Photo-Finish/aviation-model/README.md

# aviation-model
A log of the aviation competition 2025-26. Non-CUADC.
