Photo-Finish/aviation-model/飞机元器件拆解/飞机元器件拆解/激光切割/主机翼/readme.md

下面是主机翼的BOM清单

//comment 2026/2/10 9:39 :等待之后过来检查一下是否齐全

//comment 2026/2/11 :检查完成

**#Part1:激光切割**

* 关于翼肋：

 		翼肋编号从1-10 (文件名： main\_wing\_第xx块翼肋 ) 每个**各打印两个**

* 关于小翼：

 		小翼(文件名：main\_wing\_平面版小翼\_可以是木板 )**打印两个**

* 第二横梁：

 		(文件名：main\_wing\_第二横梁 )**打印一个**

* 襟翼前龙骨挡板：

 		(文件名：襟翼前龙骨挡板 )**打印一个**

* 副翼前挡板：

 		(文件名：副翼前挡板) **打印两个**

**#Part2:3D打印**

* 关于副翼：

 		副翼正反(文件名分别为：副翼 、Mirror副翼 )**各打印一个**

* 关于襟翼：

 		襟翼正反(文件名分别为：襟翼 、Mirror襟翼 )**各打印一个**

**#Part3:其他材料**

* 碳纤维管 **半径**：4mm  长度： 570mm  购买两个
