Photo-Finish/aviation-model/飞机元器件拆解/飞机元器件拆解/激光切割/垂直尾翼/readme.md

下面是垂直尾翼的BOM清单

//comment 2026/2/11 10:39 ：等待检查

//comment 2026/2/11 10:45 :已经检查

**#Part1:激光切割**

* 关于翼肋：

 		翼肋编号从 一到二 (文件名： fin\_第xx翼肋\_高度为59 ) 每个**各打印一个**

* 方向舵前挡板：

 		(文件名：fin\_方向舵前挡板\_高度为59 )**打印一个**

* 卡扣：

 		(文件名：fin\_卡扣\_高度为59)一个零件由一个部分组成 **需要打印一次**

**#Part2:3D打印**

* 关于方向舵：

 		方向舵(文件名分别为：fin\_方向舵\_高度为59 )**打印一个**

**#Part3:其他材料**

* 碳纤维管 **半径**：0.25mm  长度： 85mm  购买一个
