Photo-Finish/aviation-model/飞机元器件拆解/飞机元器件拆解/激光切割/水平尾翼/readme.md

下面是水平尾翼的BOM清单

//comment 2026/2/11 10:20 ：等待检查

//comment 2026/2/11 10:25 :已经检查

**#Part1:激光切割**

* 关于翼肋：

 		翼肋编号从 一到六 (文件名： tail\_第xx块翼肋 ) 每个**各打印两个**

* 升降舵前挡板：

 		(文件名：襟翼前龙骨挡板 )**打印两个**

* 卡扣：

&nbsp;		(文件名：tail\_卡扣)一个零件由独立的两部分组成 **需要打印两次**

**#Part2:3D打印**

* 关于升降舵：

 		升降舵正反(文件名分别为：升降舵 、Mirror升降舵 )**各打印一个**

**#Part3:其他材料**

* 碳纤维管 **半径**：2mm  长度： 350mm  购买两个
