Photo-Finish/aviation-model/飞机元器件拆解/飞机元器件拆解/readme.md

注：所有零件分成3D打印与激光切割

对于激光切割，在无特殊说明的情况下默认采用2mm厚度的轻木

同时，对于飞机每个部分 (主机翼、水平尾翼、垂直尾翼、机身)

在对于的激光切割文件夹下的对应子文件夹内有BOM表，可以查阅

3D打印默认导出为.stp/.step文件

激光切割默认导出为.dxf 图(同时记得删去非切割面)
