Photo-Finish/aviation-model/航模设计Vcs_4.0/航模设计Vcs_4.0/versions.md

###### UCAS航模三段机翼设计-yali组

**Vcs:4.0**

* **大改垂直尾翼，同时调整主机翼的安装**
* 
**Vcs:3.0**

更新公告：

* ( 气动工程师 ): 新建联合主机翼文件，参考载荷工程师的机身尺寸，制作了完整的主机翼模型
* ( 气动工程师 ): 增加水平尾翼与垂直尾翼与机身的连接件，通过榫卯结构加固了部分连接部分

**Vcs:2.0**

更新公告:

* ( 气动工程师 ): 优化了碳纤维棒穿孔的直径，通常比预设的半径大了0.1-0.2mm左右，优化了安装体验
