Photo-Finish/aviation-model/Cessna 208 Caravan.webp

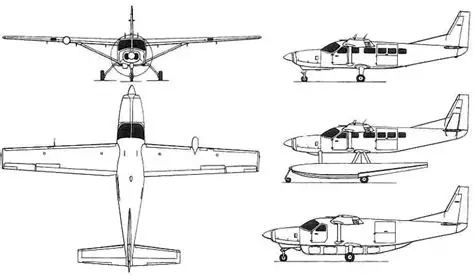
Cessna 208 Caravan.webp
