Photo-Finish/aviation-model/Fuselage/Fuck Everything ~/de Havilland DHC-2 Beaver.jpg

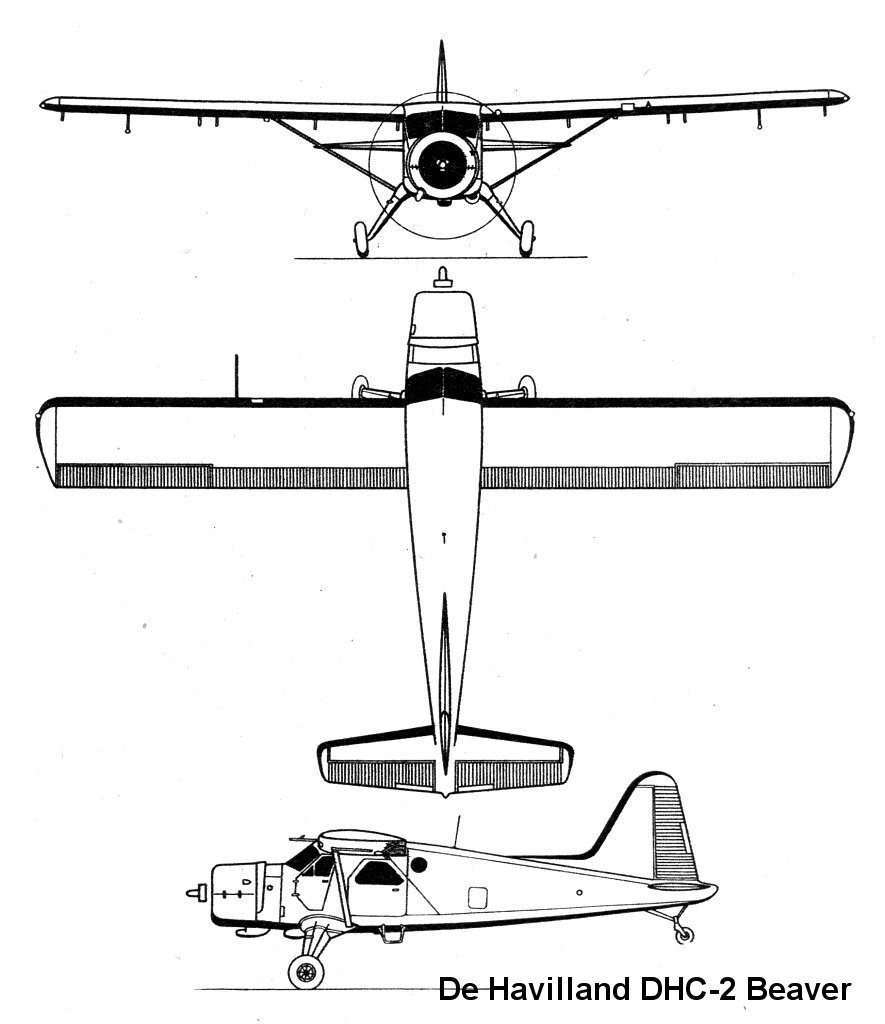
Fuselage/Fuck Everything ~/de Havilland DHC-2 Beaver.jpg
