Photo-Finish/aviation-model/航模 次终稿/modifier.jpg

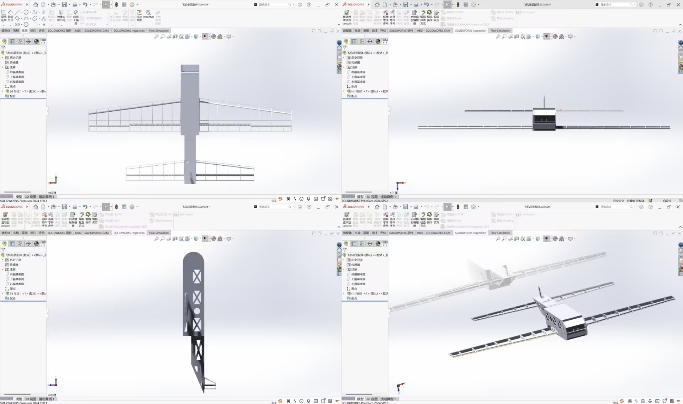
航模 次终稿/modifier.jpg
