Photo-Finish/aviation-model/航模 次终稿/λ的约束作图结果 (1).png

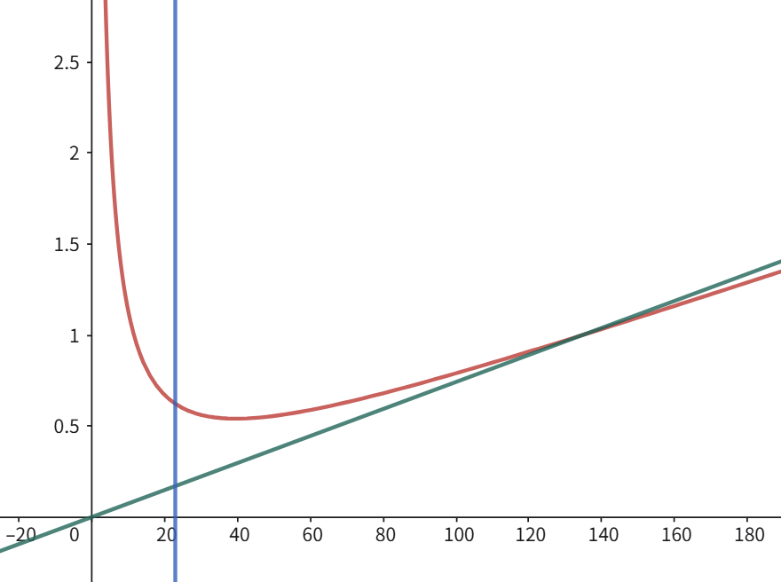
航模 次终稿/λ的约束作图结果 (1).png
