Photo-Finish/aviation-model/飞机元器件拆解/飞机元器件拆解/激光切割/主机翼/main_wing_第二块翼肋.DXF

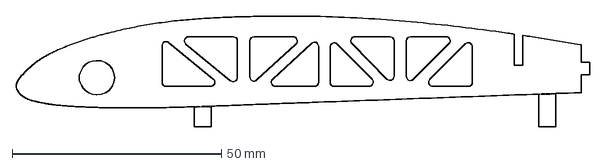
[picture p20: CAD file, 2026-07-26]
飞机元器件拆解/飞机元器件拆解/激光切割/主机翼/main_wing_第二块翼肋.DXF
136.9 x 26.5 mm
