Photo-Finish/aviation-model/飞机元器件拆解/飞机元器件拆解/激光切割/主机翼/main_wing_平面版小翼_可以是木板.DXF

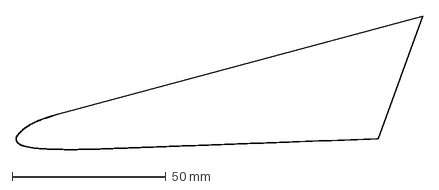
[picture p21: CAD file, 2026-07-26]
飞机元器件拆解/飞机元器件拆解/激光切割/主机翼/main_wing_平面版小翼_可以是木板.DXF
132.2 x 43.3 mm
