Photo-Finish/aviation-model/航模设计Vcs_4.0/航模设计Vcs_4.0/主机翼/main_wing_第八块翼肋.SLDPRT

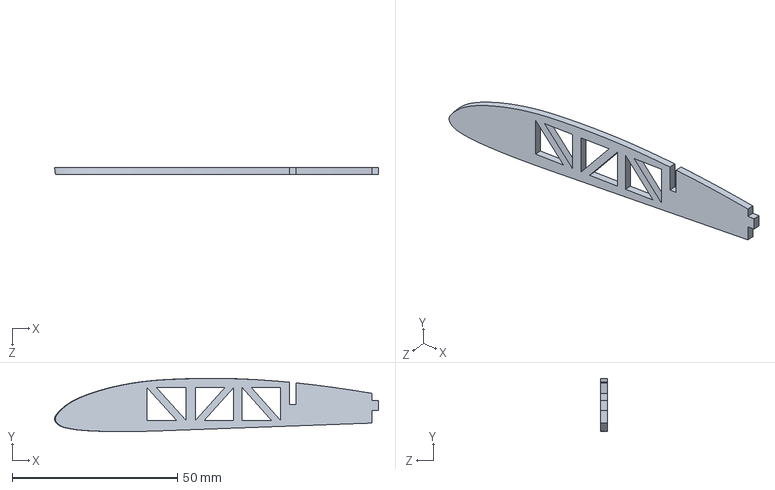
[picture p22: CAD file, 2026-07-26]
航模设计Vcs_4.0/航模设计Vcs_4.0/主机翼/main_wing_第八块翼肋.SLDPRT
98.1 x 16.1 x 2.00 mm
