Photo-Finish/aviation-model/飞机元器件拆解/飞机元器件拆解/激光切割/主机翼/main_wing_第一块翼肋.DXF

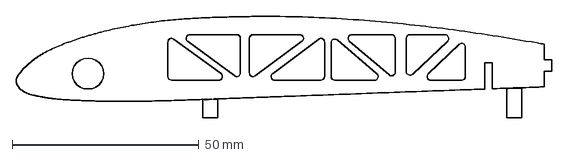
[picture p23: CAD file, 2026-07-26]
飞机元器件拆解/飞机元器件拆解/激光切割/主机翼/main_wing_第一块翼肋.DXF
143.3 x 27.1 mm
