Photo-Finish/aviation-model/飞机元器件拆解/飞机元器件拆解/激光切割/主机翼/main_wing_第三块翼肋.DXF

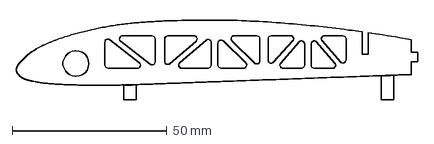
[picture p24: CAD file, 2026-07-26]
飞机元器件拆解/飞机元器件拆解/激光切割/主机翼/main_wing_第三块翼肋.DXF
129.8 x 25.9 mm
