Photo-Finish/aviation-model/航模设计Vcs_4.0/航模设计Vcs_4.0/主机翼/main_wing_第三块翼肋.SLDPRT

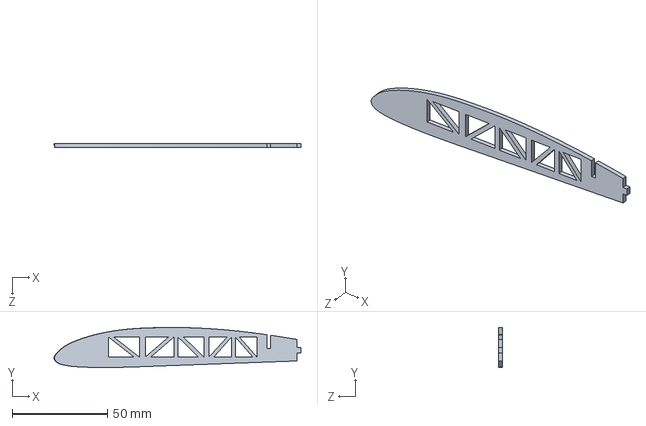
[picture p25: CAD file, 2026-07-26]
航模设计Vcs_4.0/航模设计Vcs_4.0/主机翼/main_wing_第三块翼肋.SLDPRT
129.8 x 21.1 x 2.00 mm
