Photo-Finish/aviation-model/飞机元器件拆解/飞机元器件拆解/激光切割/主机翼/main_wing_第六块翼肋.DXF

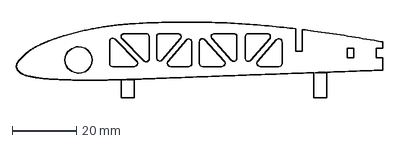
[picture p26: CAD file, 2026-07-26]
飞机元器件拆解/飞机元器件拆解/激光切割/主机翼/main_wing_第六块翼肋.DXF
113.6 x 23.5 mm
