Photo-Finish/aviation-model/航模设计Vcs_4.0/航模设计Vcs_4.0/主机翼/A_main_主机翼装配.SLDASM

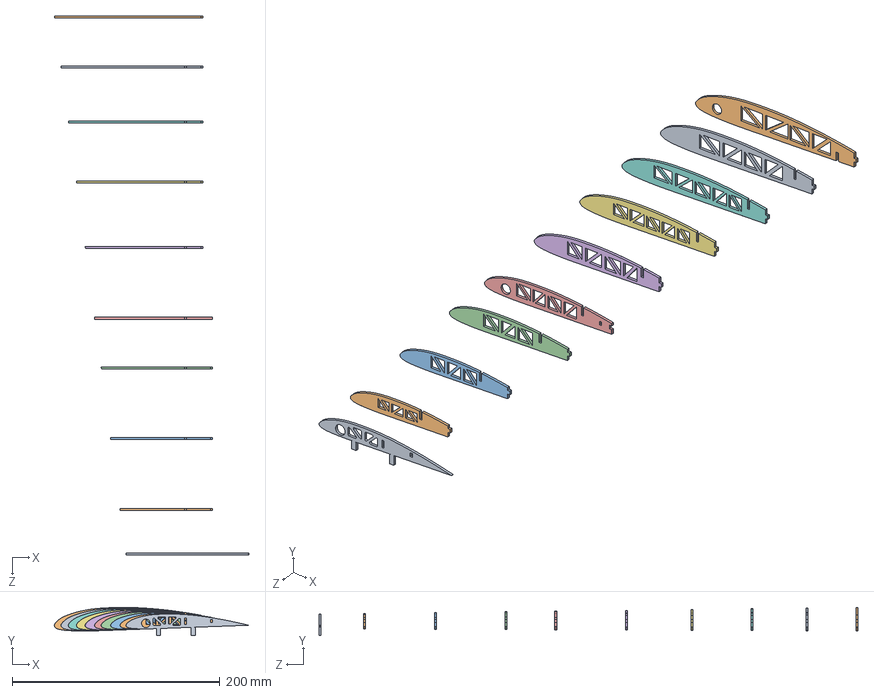
[picture p27: CAD file, 2026-07-26]
航模设计Vcs_4.0/航模设计Vcs_4.0/主机翼/A_main_主机翼装配.SLDASM
187.3 x 27.1 x 519.0 mm
main_wing_第一块翼肋
main_wing_第二块翼肋
main_wing_第三块翼肋
main_wing_第四块翼肋
main_wing_第五块翼肋
main_wing_第六块翼肋
main_wing_第七块翼肋
main_wing_第八块翼肋
main_wing_第九块翼肋
main_wing_第十块翼肋
