Photo-Finish/aviation-model/飞机元器件拆解/飞机元器件拆解/激光切割/主机翼/main_wing_第七块翼肋.DXF

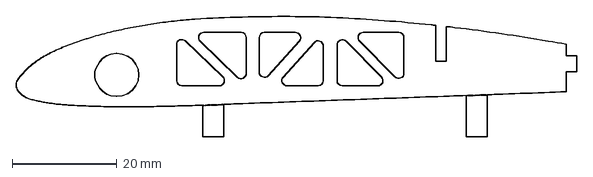
[picture p28: CAD file, 2026-07-26]
飞机元器件拆解/飞机元器件拆解/激光切割/主机翼/main_wing_第七块翼肋.DXF
107.2 x 23.0 mm
