Photo-Finish/aviation-model/航模设计Vcs_4.0/航模设计Vcs_4.0/主机翼/main_wing_第六块翼肋.SLDPRT

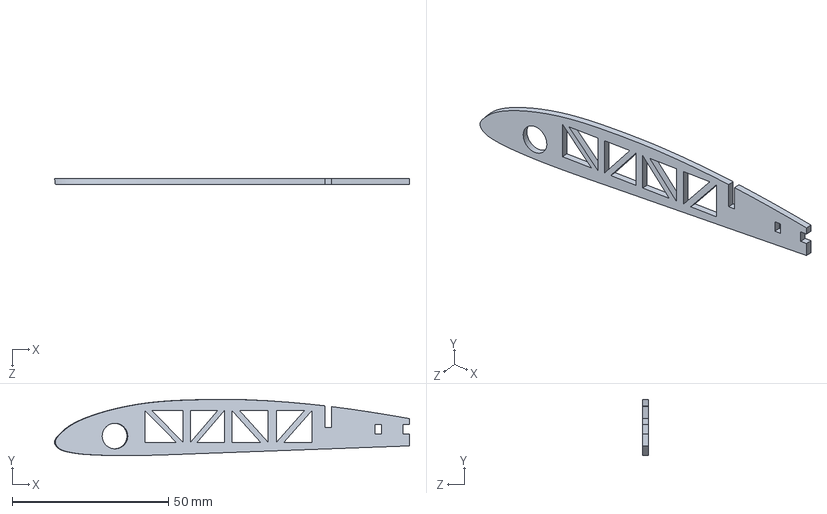
[picture p29: CAD file, 2026-07-26]
航模设计Vcs_4.0/航模设计Vcs_4.0/主机翼/main_wing_第六块翼肋.SLDPRT
113.6 x 18.0 x 2.00 mm
