Photo-Finish/aviation-model/航模设计Vcs_4.0/航模设计Vcs_4.0/主机翼/main_wing_第二横梁.SLDPRT

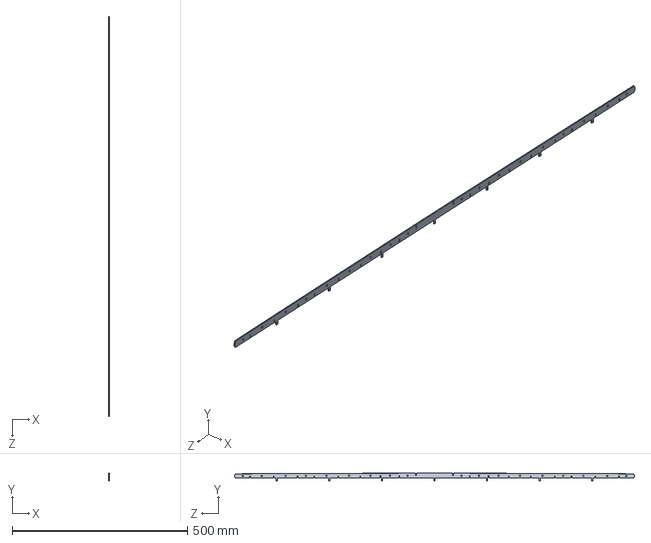
[picture p31: CAD file, 2026-07-26]
航模设计Vcs_4.0/航模设计Vcs_4.0/主机翼/main_wing_第二横梁.SLDPRT
2.00 x 22.3 x 1142.0 mm
