Photo-Finish/aviation-model/航模设计Vcs_4.0/航模设计Vcs_4.0/主机翼/main_wing_第九块翼肋.SLDPRT

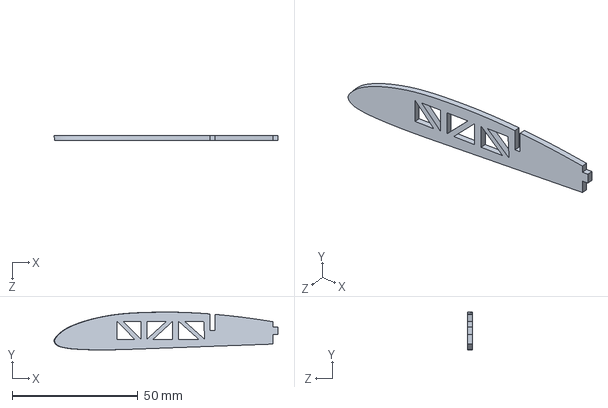
[picture p33: CAD file, 2026-07-26]
航模设计Vcs_4.0/航模设计Vcs_4.0/主机翼/main_wing_第九块翼肋.SLDPRT
89.0 x 15.0 x 2.00 mm
