Photo-Finish/aviation-model/航模设计Vcs_4.0/航模设计Vcs_4.0/主机翼/main_wing_第一横梁.SLDPRT

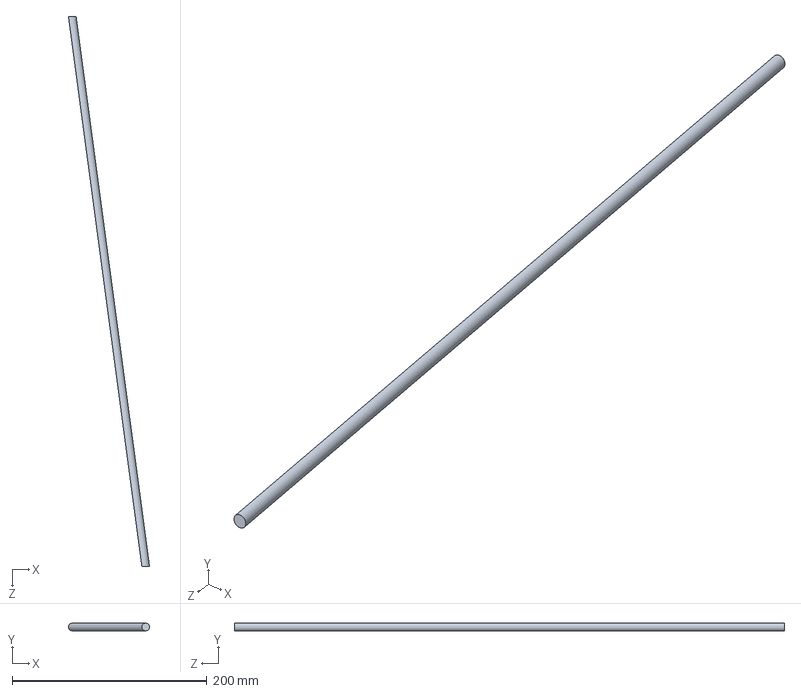
[picture p36: CAD file, 2026-07-26]
航模设计Vcs_4.0/航模设计Vcs_4.0/主机翼/main_wing_第一横梁.SLDPRT
83.4 x 7.96 x 565.0 mm
