Photo-Finish/aviation-model/航模设计Vcs_4.0/航模设计Vcs_4.0/主机翼/main_wing_第二块翼肋.SLDPRT

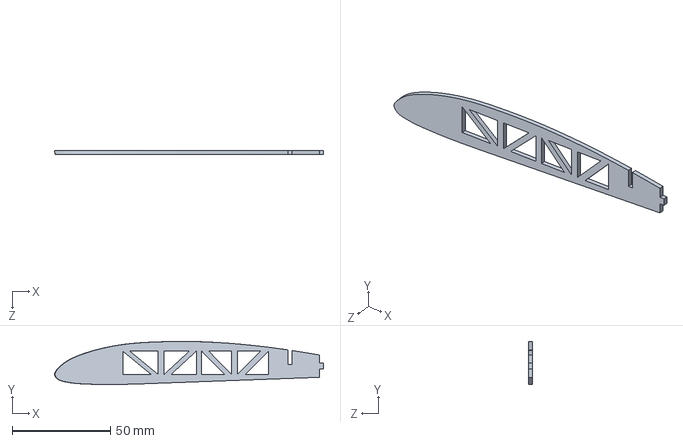
[picture p38: CAD file, 2026-07-26]
航模设计Vcs_4.0/航模设计Vcs_4.0/主机翼/main_wing_第二块翼肋.SLDPRT
136.9 x 21.9 x 2.00 mm
