Photo-Finish/aviation-model/航模设计Vcs_4.0/航模设计Vcs_4.0/主机翼/main_wing_曲面版小翼_3D打印件.SLDPRT

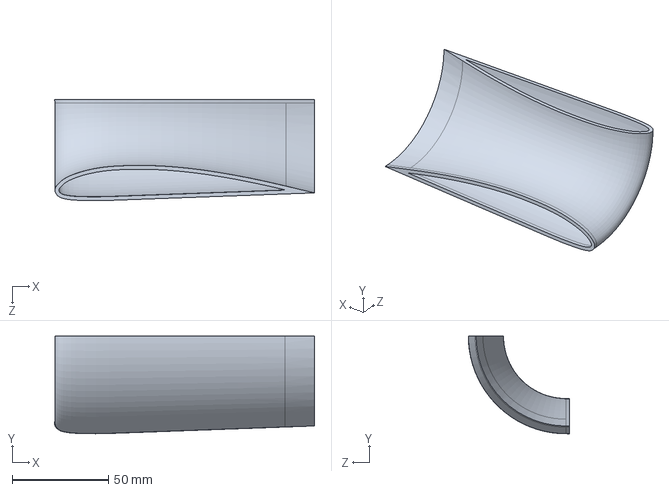
[picture p40: CAD file, 2026-07-26]
航模设计Vcs_4.0/航模设计Vcs_4.0/主机翼/main_wing_曲面版小翼_3D打印件.SLDPRT
135.1 x 50.7 x 52.7 mm
