Photo-Finish/aviation-model/航模设计Vcs_4.0/航模设计Vcs_4.0/主机翼/main_wing_第十块翼肋.SLDPRT

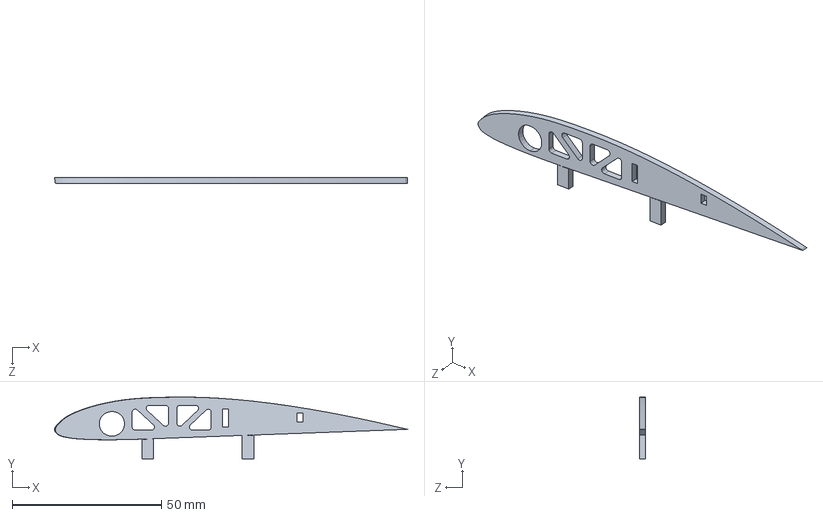
[picture p41: CAD file, 2026-07-26]
航模设计Vcs_4.0/航模设计Vcs_4.0/主机翼/main_wing_第十块翼肋.SLDPRT
118.3 x 20.8 x 2.00 mm
