Photo-Finish/aviation-model/航模设计Vcs_4.0/航模设计Vcs_4.0/主机翼/main_wing_第一块翼肋.SLDPRT

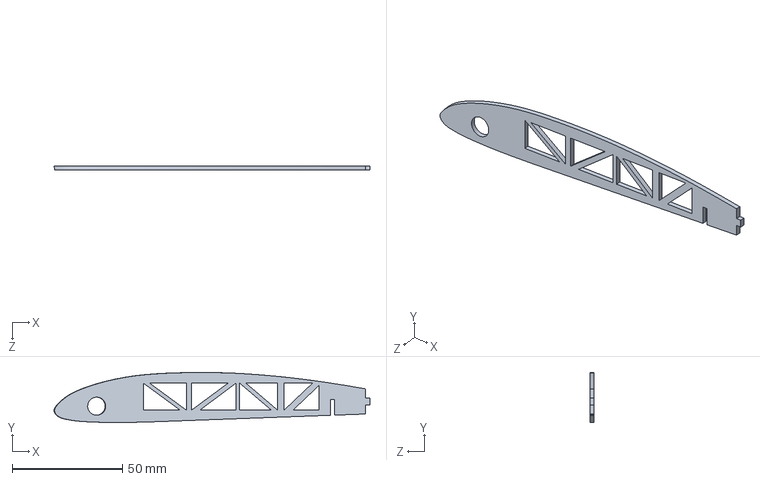
[picture p42: CAD file, 2026-07-26]
航模设计Vcs_4.0/航模设计Vcs_4.0/主机翼/main_wing_第一块翼肋.SLDPRT
143.3 x 22.7 x 2.00 mm
