Photo-Finish/aviation-model/航模设计Vcs_4.0/航模设计Vcs_4.0/主机翼/main_wing_第七块翼肋.SLDPRT

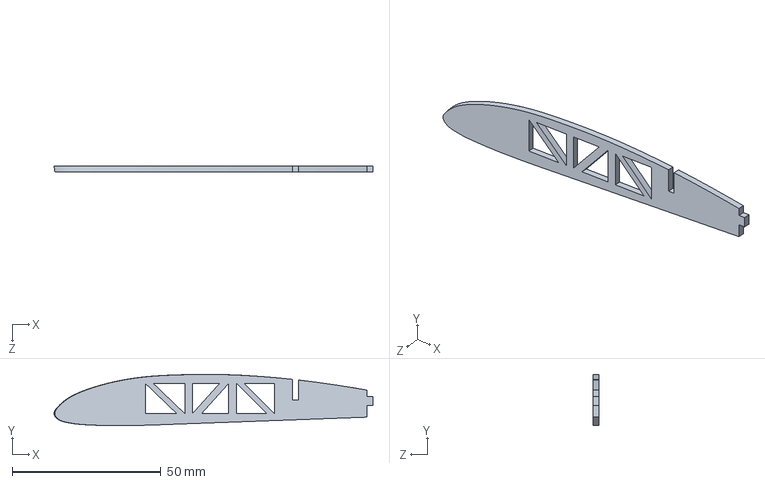
[picture p44: CAD file, 2026-07-26]
航模设计Vcs_4.0/航模设计Vcs_4.0/主机翼/main_wing_第七块翼肋.SLDPRT
107.2 x 17.3 x 2.00 mm
