Photo-Finish/aviation-model/航模设计Vcs_4.0/航模设计Vcs_4.0/主机翼/main_wing_引导塑料薄膜附着.SLDPRT

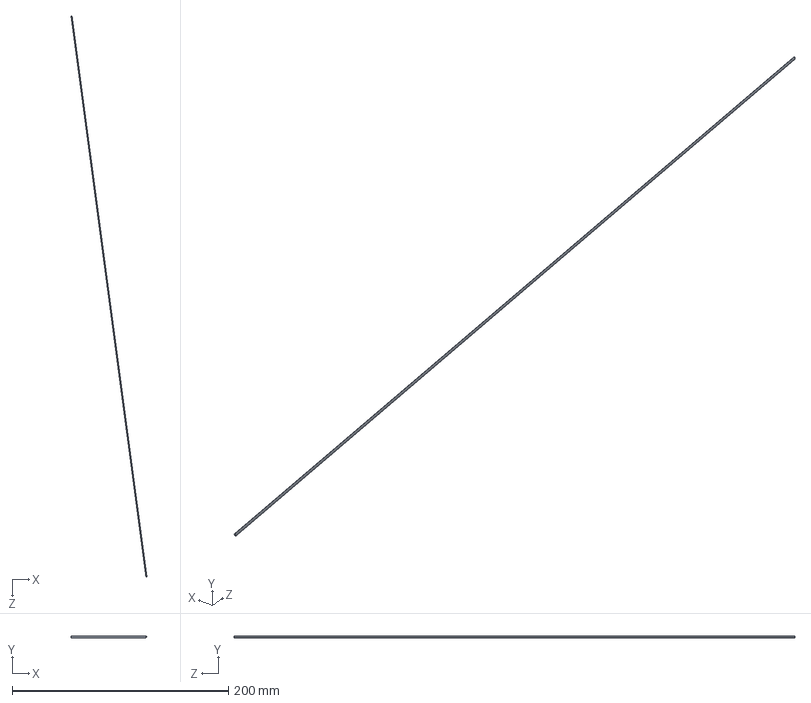
[picture p45: CAD file, 2026-07-26]
航模设计Vcs_4.0/航模设计Vcs_4.0/主机翼/main_wing_引导塑料薄膜附着.SLDPRT
70.3 x 1.68 x 519.0 mm
