Photo-Finish/aviation-model/航模设计Vcs_4.0/航模设计Vcs_4.0/主机翼/main_wing_平面版小翼_可以是木板.SLDPRT

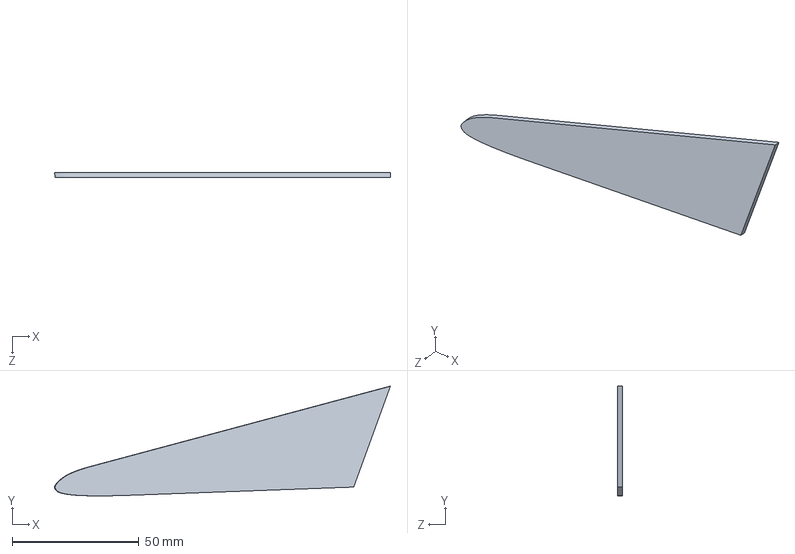
[picture p46: CAD file, 2026-07-26]
航模设计Vcs_4.0/航模设计Vcs_4.0/主机翼/main_wing_平面版小翼_可以是木板.SLDPRT
132.5 x 43.4 x 2.00 mm
