Photo-Finish/aviation-model/航模设计Vcs_4.0/航模设计Vcs_4.0/主机翼/main_wing_第四块翼肋.SLDPRT

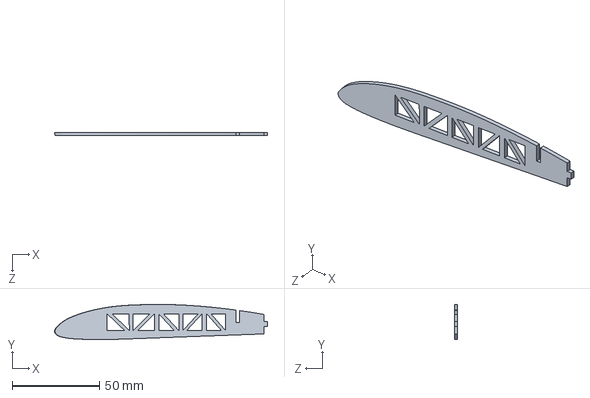
[picture p47: CAD file, 2026-07-26]
航模设计Vcs_4.0/航模设计Vcs_4.0/主机翼/main_wing_第四块翼肋.SLDPRT
122.1 x 20.2 x 2.00 mm
