Photo-Finish/aviation-model/_temp/tail side original.SLDPRT

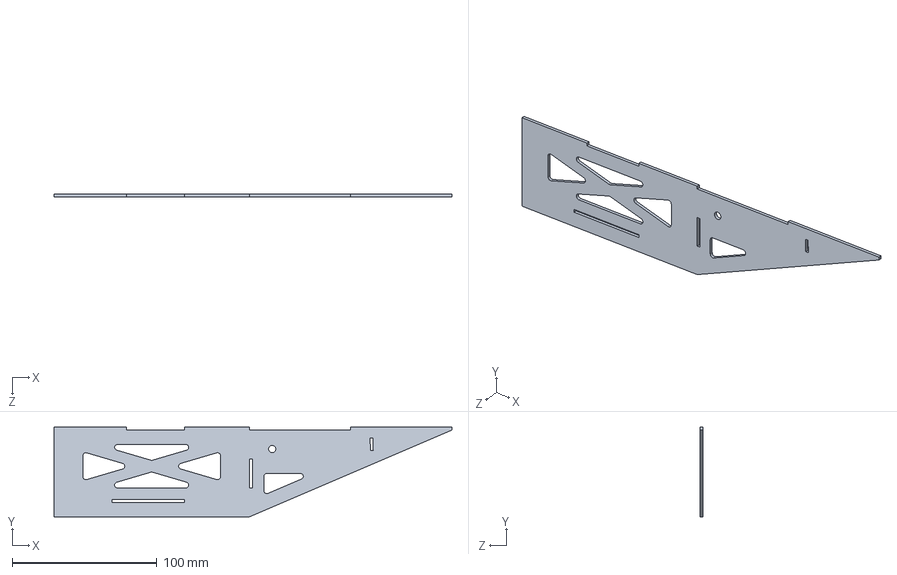
[picture p48: CAD file, 2026-07-26]
_temp/tail side original.SLDPRT
275.0 x 62.0 x 2.00 mm
