Photo-Finish/aviation-model/Apr. mod/windshear.SLDPRT

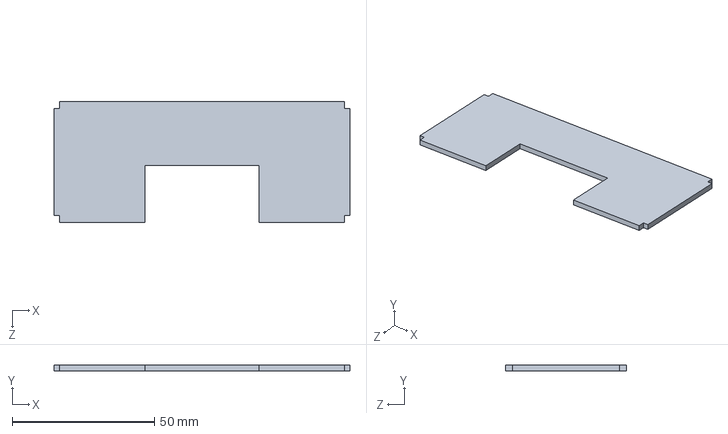
[picture p49: CAD file, 2026-07-26]
Apr. mod/windshear.SLDPRT
104.0 x 2.00 x 42.5 mm
