Photo-Finish/aviation-model/Fuselage/Fuck Everything Again ~/机头半圆形挡板.SLDPRT

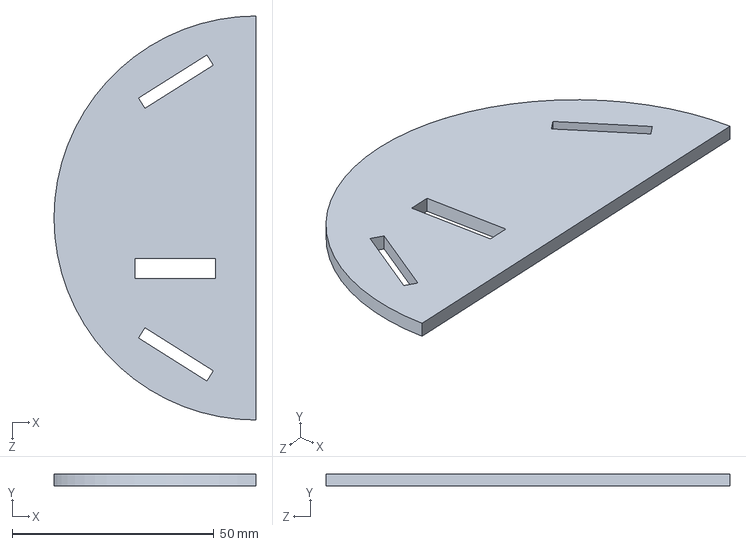
[picture p50: CAD file, 2026-07-26]
Fuselage/Fuck Everything Again ~/机头半圆形挡板.SLDPRT
50.0 x 3.00 x 100.0 mm
