Photo-Finish/aviation-model/Fuselage/tail floor.SLDPRT

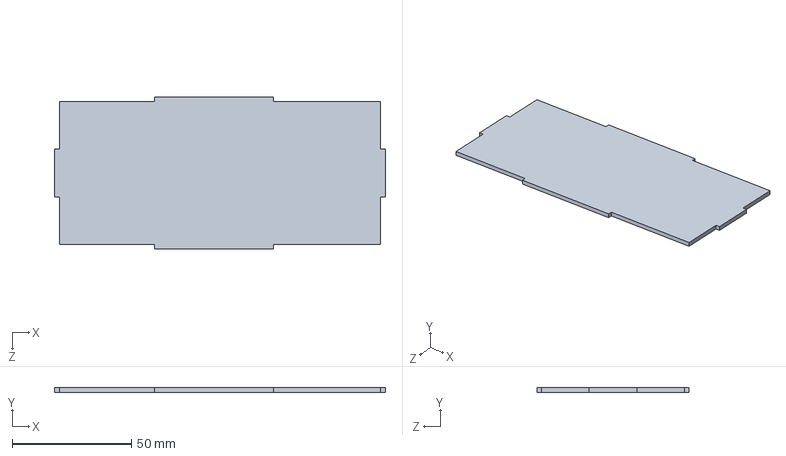
[picture p51: CAD file, 2026-07-26]
Fuselage/tail floor.SLDPRT
139.0 x 2.00 x 64.0 mm
