Photo-Finish/aviation-model/主机翼/主机翼/第二横梁.SLDPRT

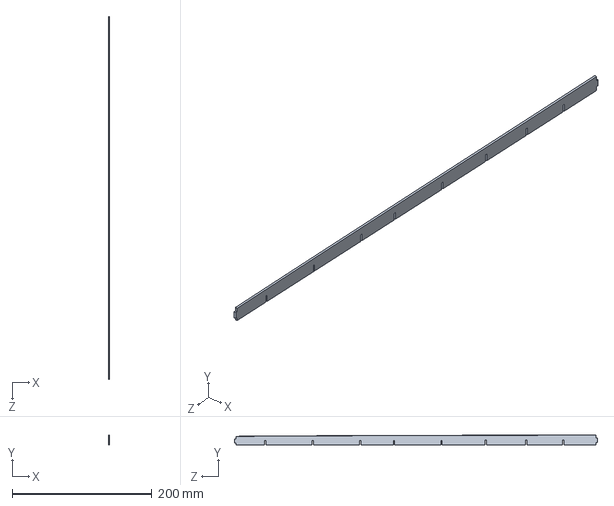
[picture p52: CAD file, 2026-07-26]
主机翼/主机翼/第二横梁.SLDPRT
2.00 x 14.6 x 519.0 mm
