Photo-Finish/aviation-model/垂直尾翼/垂直尾翼/塑料薄膜附着处.SLDPRT

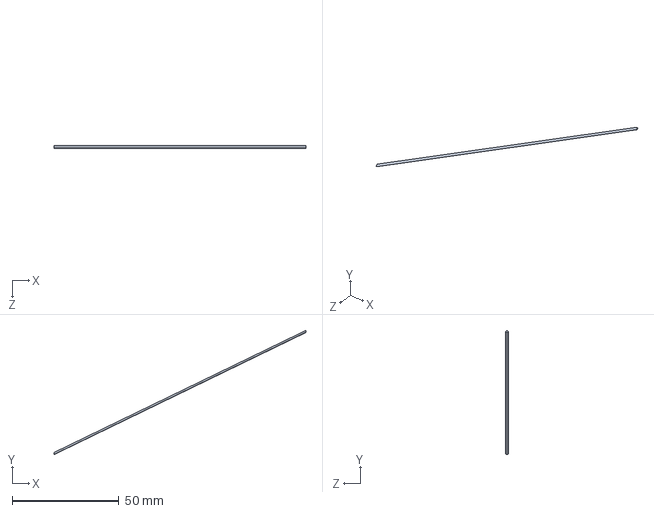
[picture p53: CAD file, 2026-07-26]
垂直尾翼/垂直尾翼/塑料薄膜附着处.SLDPRT
118.0 x 58.2 x 1.37 mm
