Photo-Finish/aviation-model/改个锤子！八十！/wheel struct F.STEP

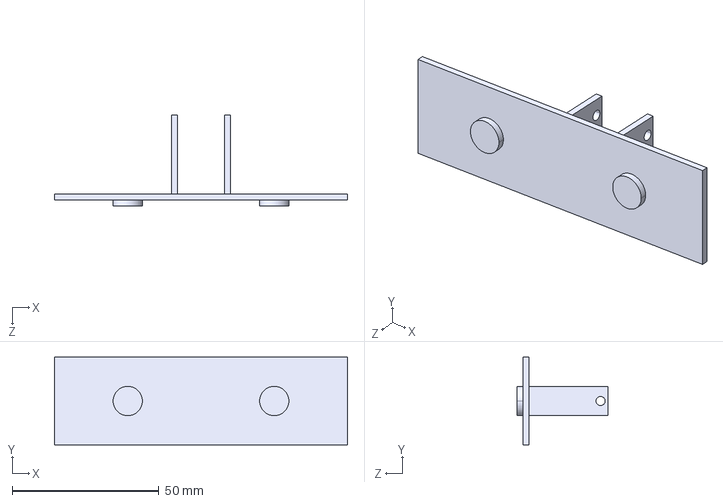
[picture p54: CAD file, 2026-07-26]
改个锤子！八十！/wheel struct F.STEP
100.0 x 30.0 x 31.0 mm
