Photo-Finish/aviation-model/水平尾翼/水平尾翼/升降舵前挡板.SLDPRT

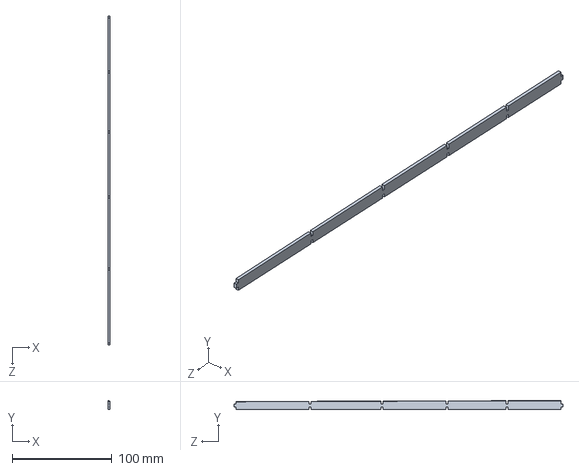
[picture p55: CAD file, 2026-07-26]
水平尾翼/水平尾翼/升降舵前挡板.SLDPRT
2.00 x 8.78 x 329.0 mm
