Photo-Finish/aviation-model/航模设计Vcs_4.0/航模设计Vcs_4.0/主机翼第二横梁固定件_总.SLDPRT

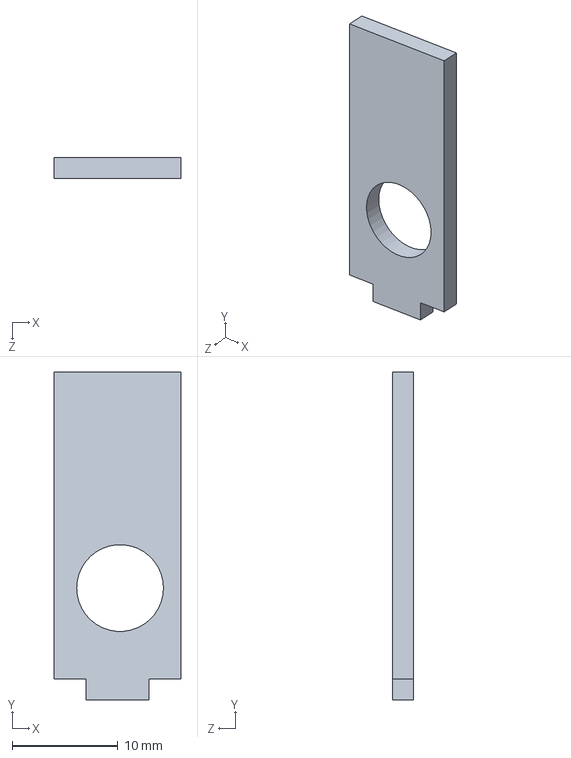
[picture p56: CAD file, 2026-07-26]
航模设计Vcs_4.0/航模设计Vcs_4.0/主机翼第二横梁固定件_总.SLDPRT
12.0 x 31.0 x 2.00 mm
