Photo-Finish/aviation-model/跑CFD的水平尾翼(只有一半).SLDPRT

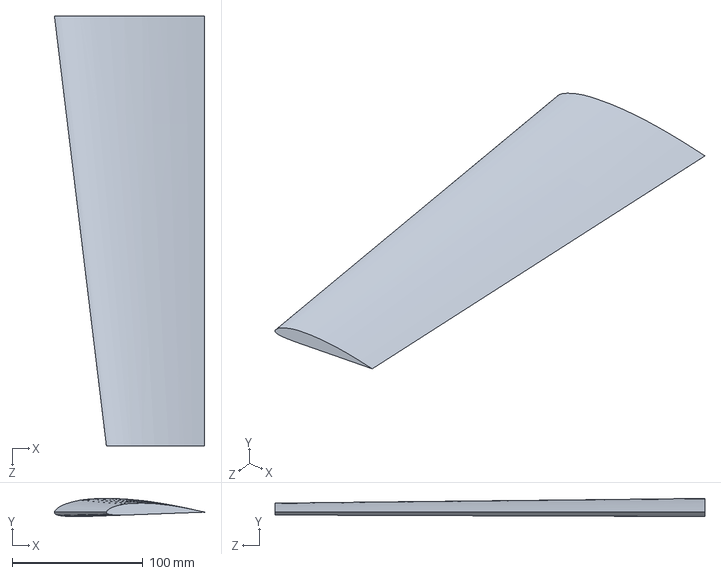
[picture p57: CAD file, 2026-07-26]
跑CFD的水平尾翼(只有一半).SLDPRT
114.9 x 13.9 x 329.0 mm
