Photo-Finish/aviation-model/飞机元器件拆解/飞机元器件拆解/3D打印/Mirror升降舵.STEP

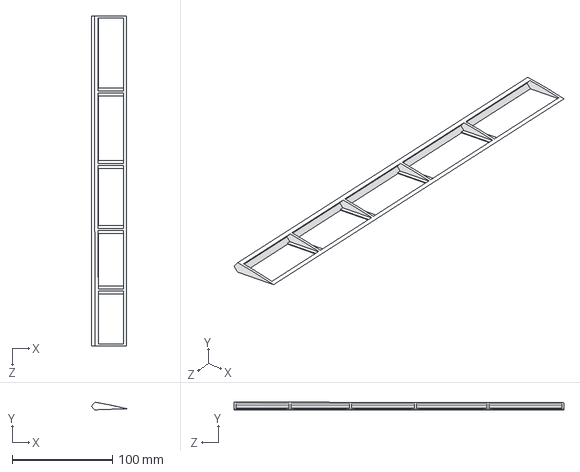
[picture p58: CAD file, 2026-07-26]
飞机元器件拆解/飞机元器件拆解/3D打印/Mirror升降舵.STEP
35.0 x 7.72 x 329.0 mm
