Photo-Finish/aviation-model/飞机元器件拆解/飞机元器件拆解/激光切割/垂直尾翼/fin_方向舵前挡板_高度为59.DXF

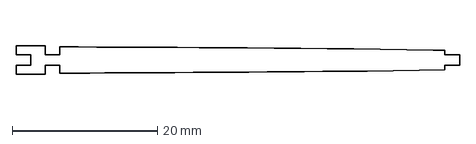
[picture p59: CAD file, 2026-07-26]
飞机元器件拆解/飞机元器件拆解/激光切割/垂直尾翼/fin_方向舵前挡板_高度为59.DXF
61.0 x 3.87 mm
