Photo-Finish/aviation-model/飞机元器件拆解/飞机元器件拆解/激光切割/水平尾翼/tail_第六块翼肋.DXF

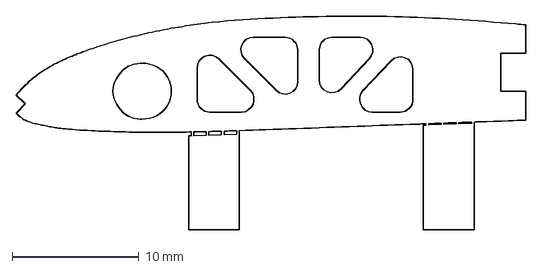
[picture p60: CAD file, 2026-07-26]
飞机元器件拆解/飞机元器件拆解/激光切割/水平尾翼/tail_第六块翼肋.DXF
40.3 x 16.9 mm
