Photo-Finish/aviation-model/Apr. mod/engine mount, floor.SLDPRT

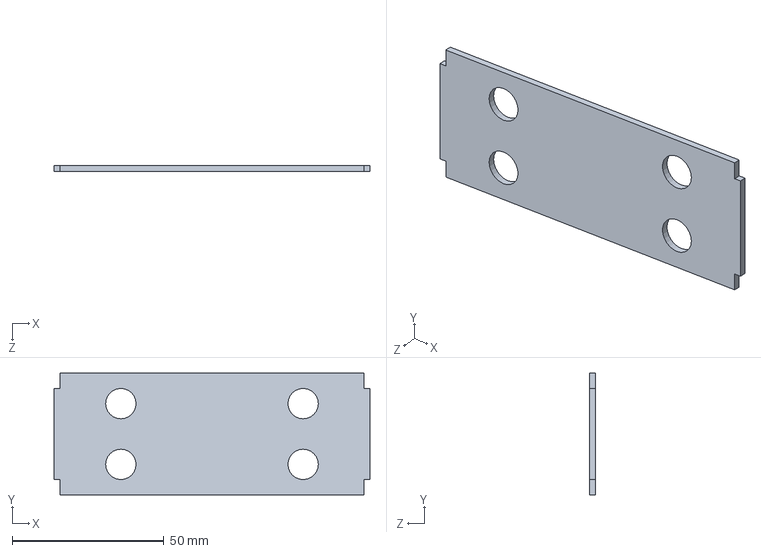
[picture p61: CAD file, 2026-07-26]
Apr. mod/engine mount, floor.SLDPRT
104.0 x 40.0 x 2.00 mm
