Photo-Finish/aviation-model/Fuselage/Fuck Everything Again ~/机头上下斜挡板.SLDPRT

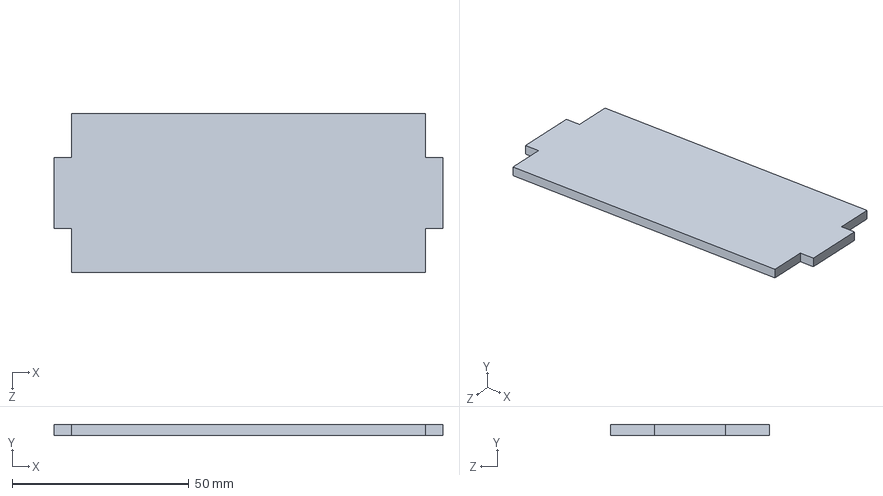
[picture p62: CAD file, 2026-07-26]
Fuselage/Fuck Everything Again ~/机头上下斜挡板.SLDPRT
110.0 x 3.00 x 45.0 mm
