Photo-Finish/aviation-model/Fuselage/Fuck Everything ~/Fuselage.stp

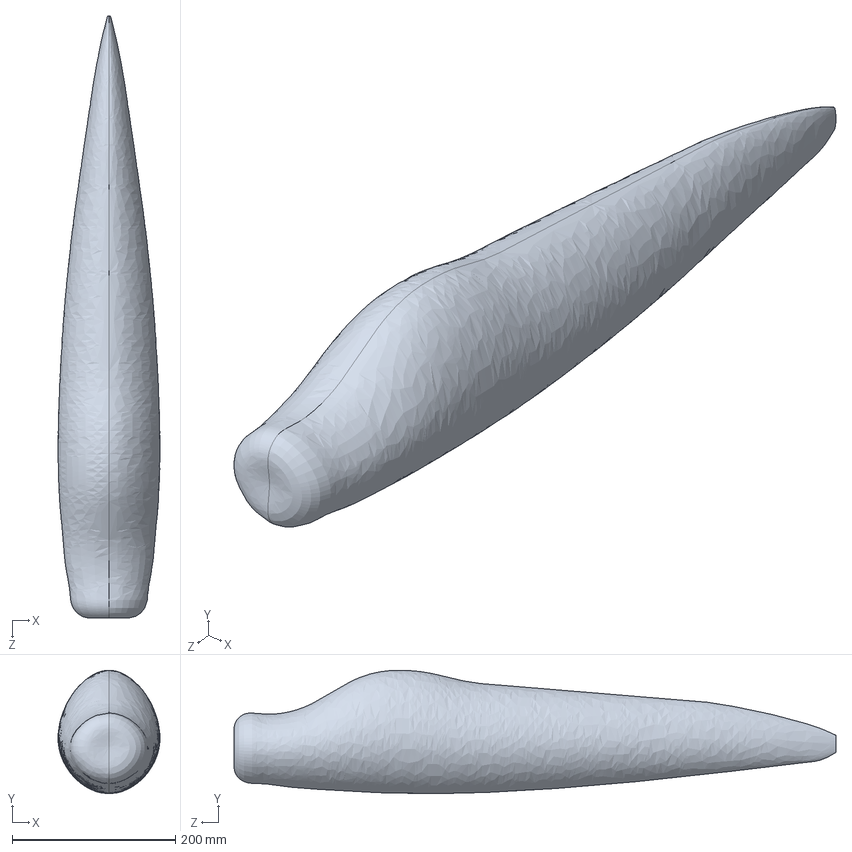
[picture p63: CAD file, 2026-07-26]
Fuselage/Fuck Everything ~/Fuselage.stp
124.7 x 151.2 x 737.1 mm
