Photo-Finish/aviation-model/Fuselage/side panel - holy fuck.SLDPRT

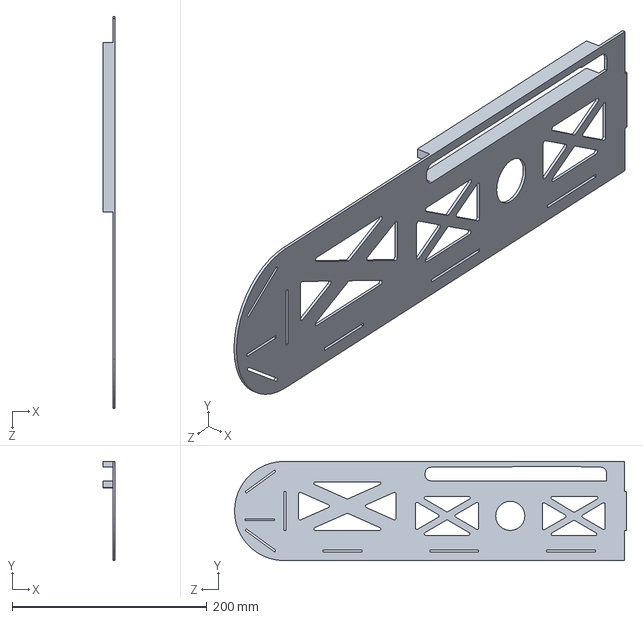
[picture p64: CAD file, 2026-07-26]
Fuselage/side panel - holy fuck.SLDPRT
12.0 x 102.0 x 403.0 mm
