Photo-Finish/aviation-model/垂直尾翼/垂直尾翼/第二翼肋.SLDPRT

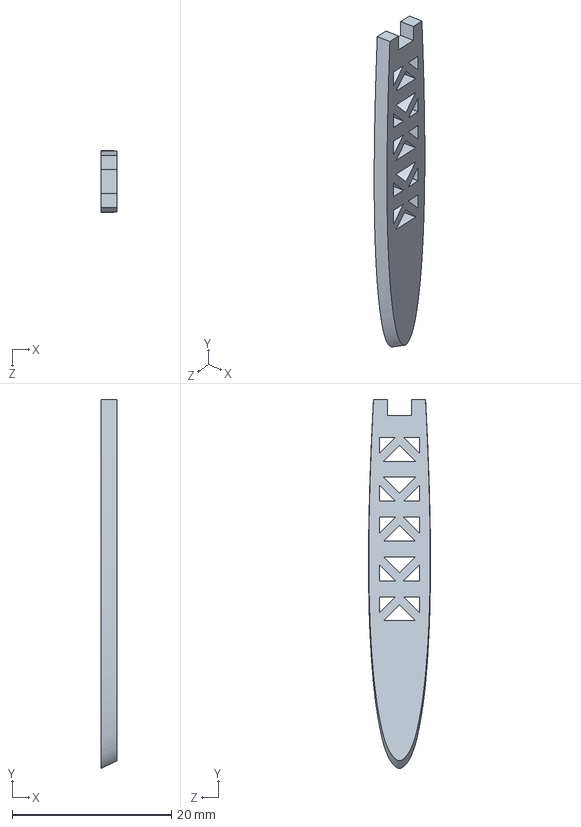
[picture p65: CAD file, 2026-07-26]
垂直尾翼/垂直尾翼/第二翼肋.SLDPRT
2.00 x 46.3 x 7.78 mm
