Photo-Finish/aviation-model/改个锤子！八十！/零件1.STEP

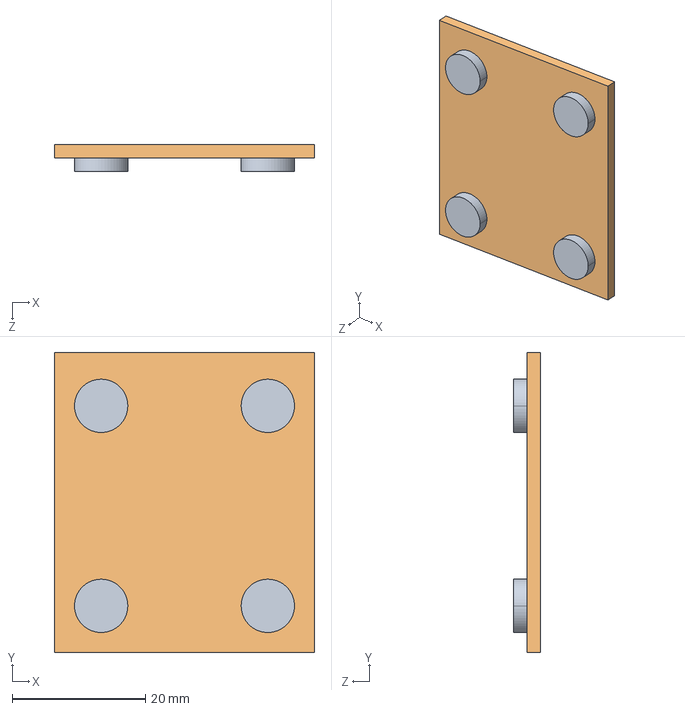
[picture p66: CAD file, 2026-07-26]
改个锤子！八十！/零件1.STEP
39.0 x 45.0 x 4.00 mm
