Photo-Finish/aviation-model/正式版/FIN, mod.dxf

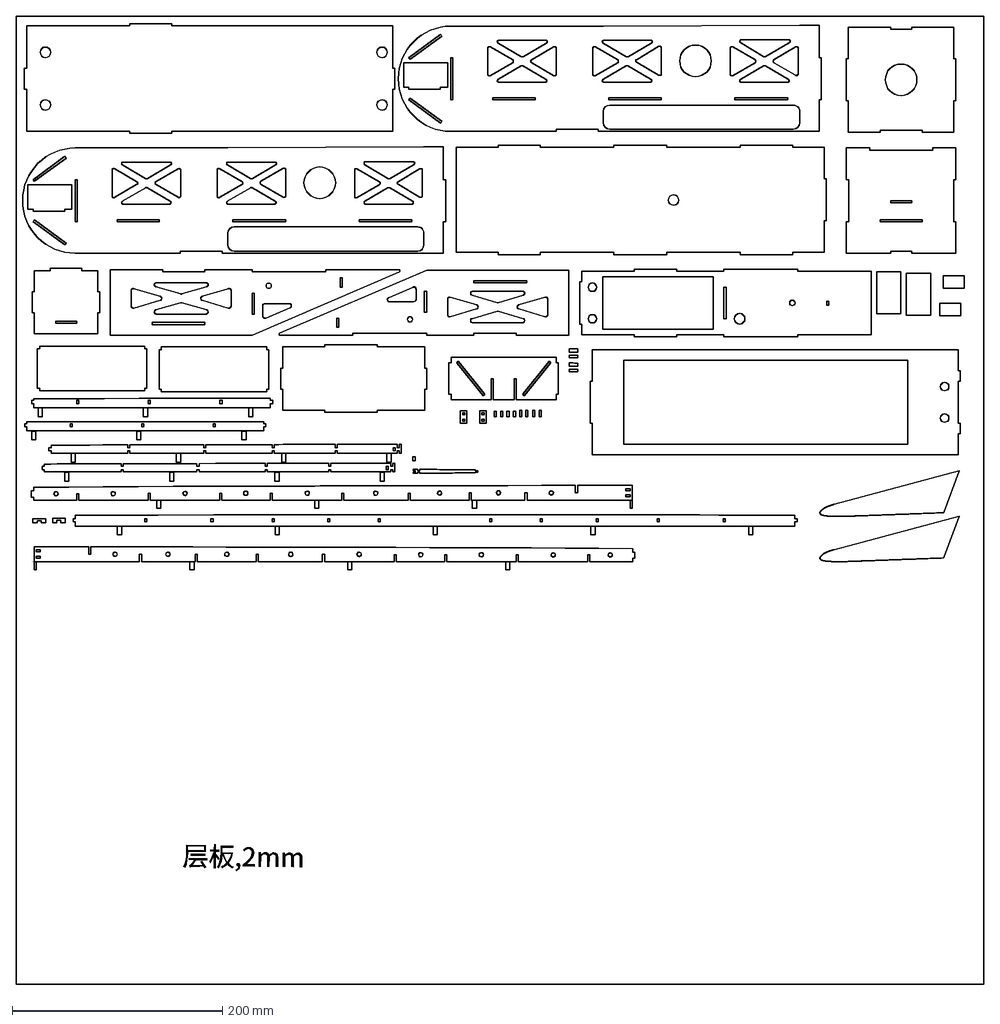
[picture p67: CAD file, 2026-07-26]
正式版/FIN, mod.dxf
层板,2mm
