Photo-Finish/aviation-model/水平尾翼/水平尾翼/塑料薄膜附着位点.SLDPRT

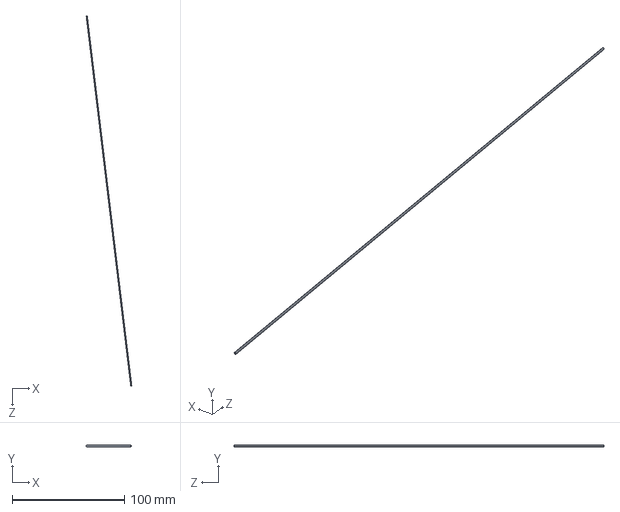
[picture p68: CAD file, 2026-07-26]
水平尾翼/水平尾翼/塑料薄膜附着位点.SLDPRT
40.6 x 1.55 x 329.0 mm
