Photo-Finish/aviation-model/航模设计Vcs_4.0/航模设计Vcs_4.0/4_0_gear mount.SLDPRT

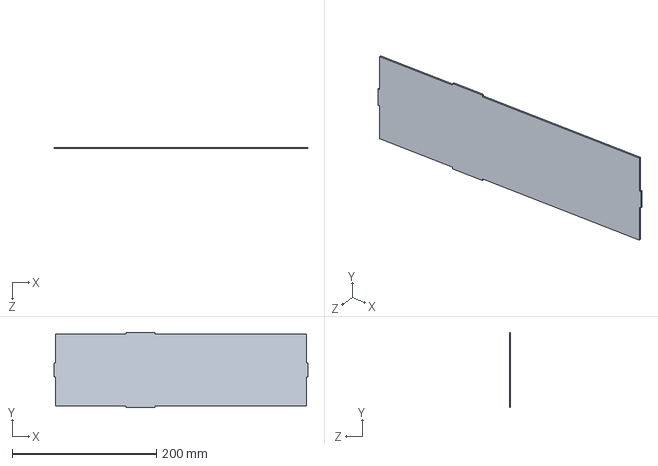
[picture p69: CAD file, 2026-07-26]
航模设计Vcs_4.0/航模设计Vcs_4.0/4_0_gear mount.SLDPRT
352.0 x 104.0 x 2.00 mm
