Photo-Finish/aviation-model/航模设计Vcs_4.0/航模设计Vcs_4.0/垂直尾翼/方向舵.SLDPRT

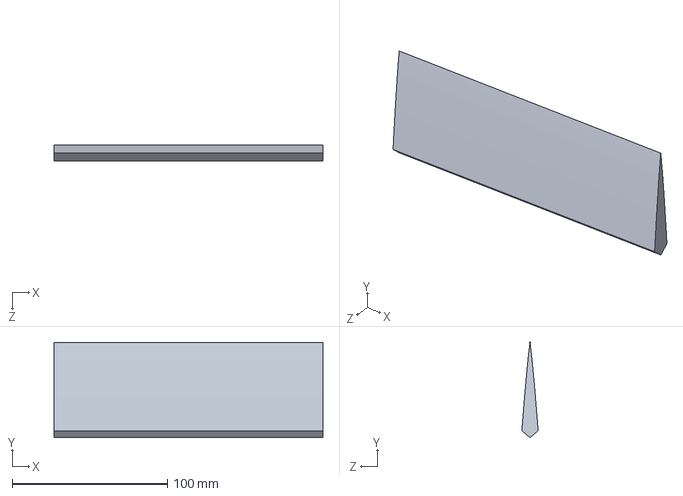
[picture p70: CAD file, 2026-07-26]
航模设计Vcs_4.0/航模设计Vcs_4.0/垂直尾翼/方向舵.SLDPRT
173.0 x 61.3 x 10.5 mm
