Photo-Finish/aviation-model/航模设计Vcs_4.0/航模设计Vcs_4.0/水平尾翼/tail_第三块翼肋.SLDPRT

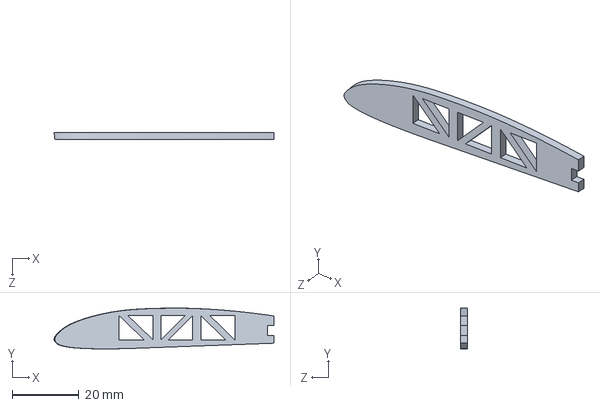
[picture p71: CAD file, 2026-07-26]
航模设计Vcs_4.0/航模设计Vcs_4.0/水平尾翼/tail_第三块翼肋.SLDPRT
66.1 x 12.3 x 2.00 mm
