Photo-Finish/aviation-model/跑CFD的主机翼(对称两半).SLDPRT

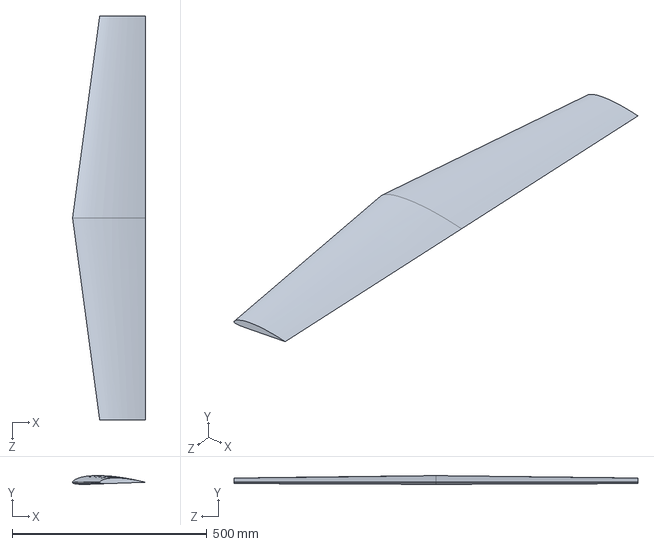
[picture p72: CAD file, 2026-07-26]
跑CFD的主机翼(对称两半).SLDPRT
187.3 x 22.6 x 1038.0 mm
