Photo-Finish/aviation-model/飞机元器件拆解/飞机元器件拆解/3D打印/Mirror襟翼.STEP

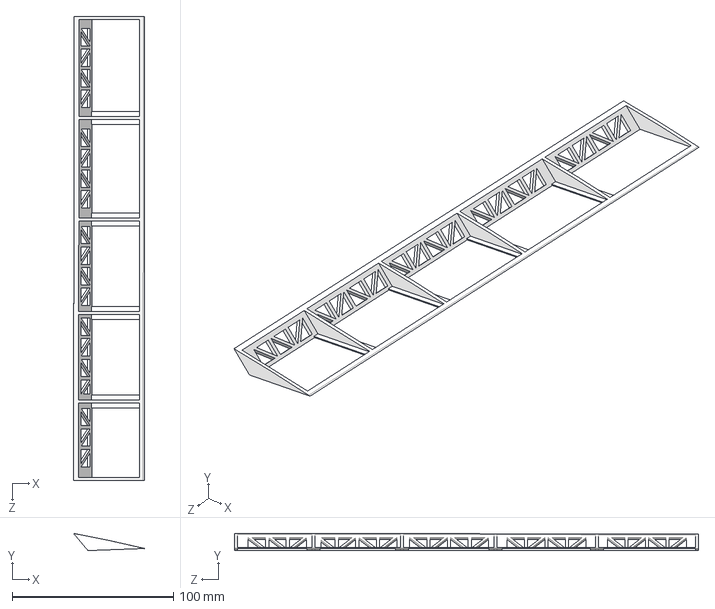
[picture p73: CAD file, 2026-07-26]
飞机元器件拆解/飞机元器件拆解/3D打印/Mirror襟翼.STEP
44.0 x 10.6 x 288.0 mm
