Photo-Finish/aviation-model/飞机元器件拆解/飞机元器件拆解/激光切割/垂直尾翼/fin_卡扣_高度为59.DXF

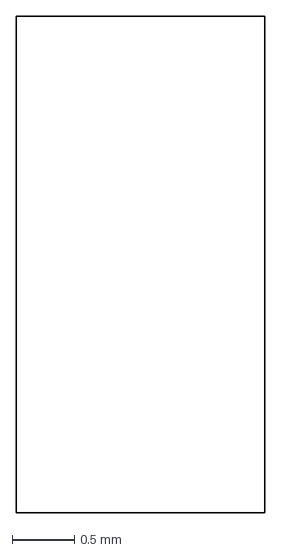
[picture p74: CAD file, 2026-07-26]
飞机元器件拆解/飞机元器件拆解/激光切割/垂直尾翼/fin_卡扣_高度为59.DXF
2.00 x 4.00 mm
