Photo-Finish/aviation-model/飞机元器件拆解/飞机元器件拆解/激光切割/水平尾翼/tail_第一块翼肋.DXF

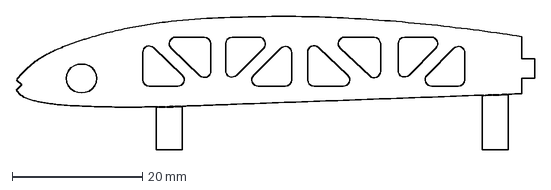
[picture p75: CAD file, 2026-07-26]
飞机元器件拆解/飞机元器件拆解/激光切割/水平尾翼/tail_第一块翼肋.DXF
79.7 x 20.5 mm
