Photo-Finish/aviation-model/Apr. mod/comb.dxf

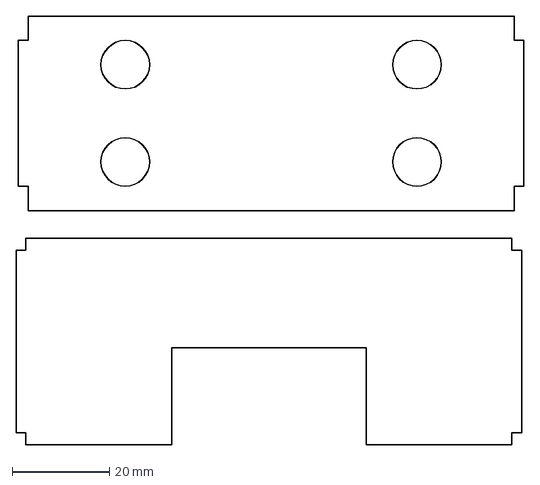
[picture p76: CAD file, 2026-07-26]
Apr. mod/comb.dxf
104.5 x 88.2 mm
