Photo-Finish/aviation-model/Fuselage/tail ceiling.SLDPRT

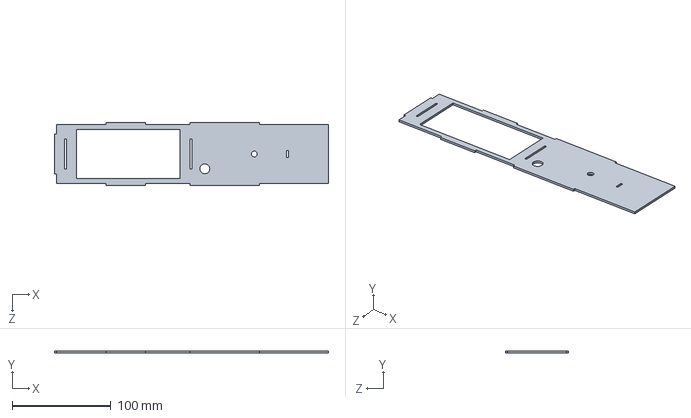
[picture p77: CAD file, 2026-07-26]
Fuselage/tail ceiling.SLDPRT
277.0 x 2.00 x 64.0 mm
