Photo-Finish/aviation-model/垂直尾翼.SLDPRT

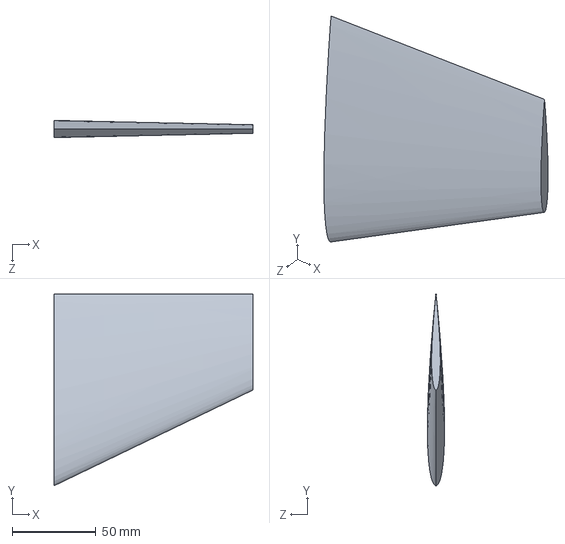
[picture p78: CAD file, 2026-07-26]
垂直尾翼.SLDPRT
118.8 x 114.4 x 10.3 mm
