Photo-Finish/aviation-model/垂直尾翼/垂直尾翼/第三翼肋.SLDPRT

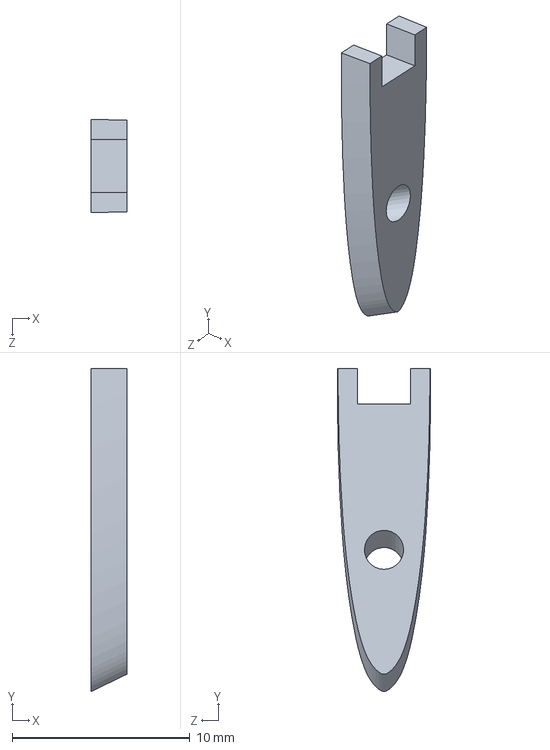
[picture p79: CAD file, 2026-07-26]
垂直尾翼/垂直尾翼/第三翼肋.SLDPRT
2.00 x 18.2 x 5.24 mm
