Photo-Finish/aviation-model/改个锤子！八十！/wheel struct.STEP

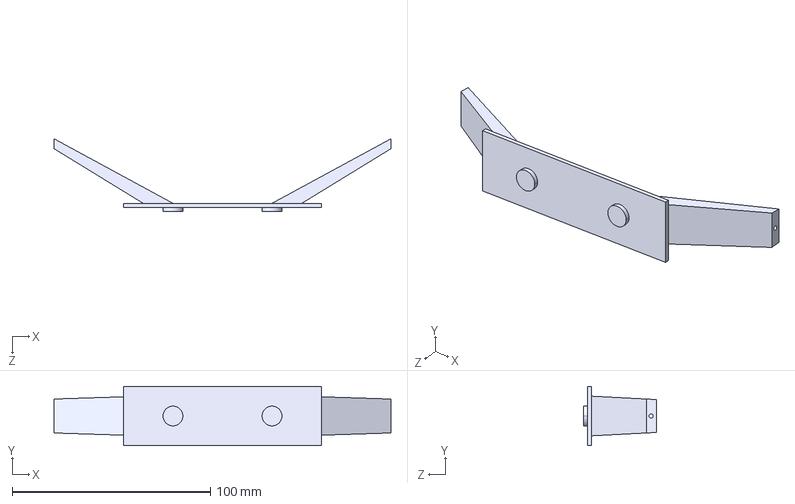
[picture p80: CAD file, 2026-07-26]
改个锤子！八十！/wheel struct.STEP
170.0 x 30.0 x 36.6 mm
