Photo-Finish/aviation-model/水平尾翼/水平尾翼/第一块翼肋.SLDPRT

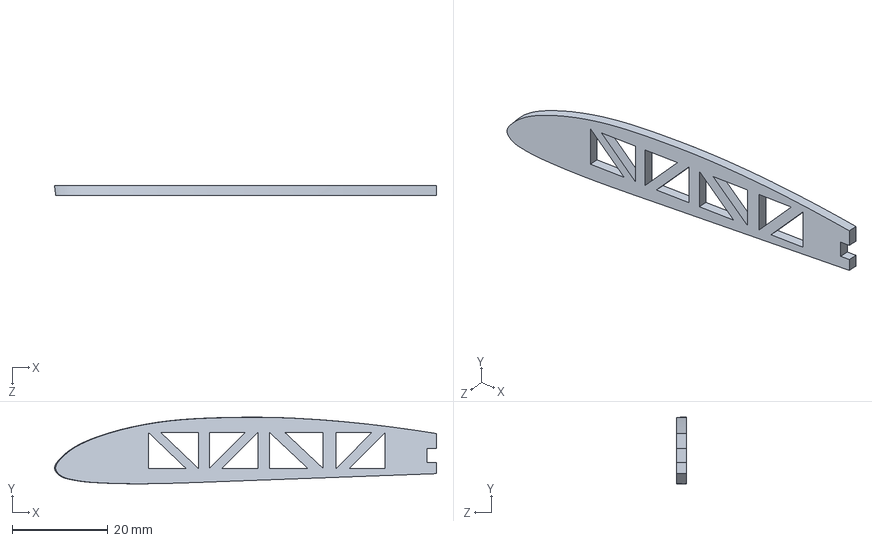
[picture p81: CAD file, 2026-07-26]
水平尾翼/水平尾翼/第一块翼肋.SLDPRT
79.9 x 13.9 x 2.00 mm
