Photo-Finish/aviation-model/航模设计Vcs_4.0/航模设计Vcs_4.0/主机翼碳棒固定件 (2).SLDPRT

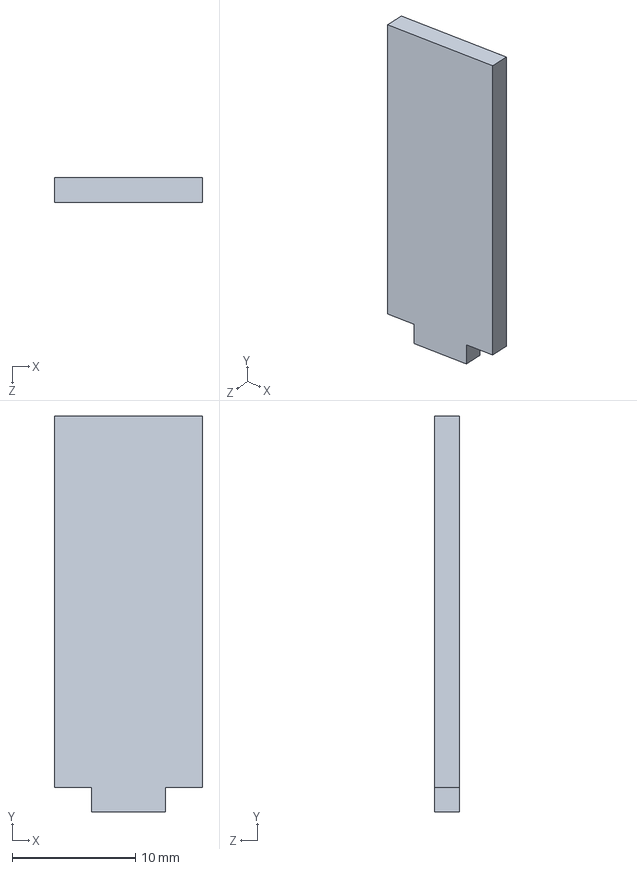
[picture p82: CAD file, 2026-07-26]
航模设计Vcs_4.0/航模设计Vcs_4.0/主机翼碳棒固定件 (2).SLDPRT
12.0 x 32.1 x 2.00 mm
