Photo-Finish/aviation-model/航模设计Vcs_4.0/航模设计Vcs_4.0/垂直尾翼/第一横梁.SLDPRT

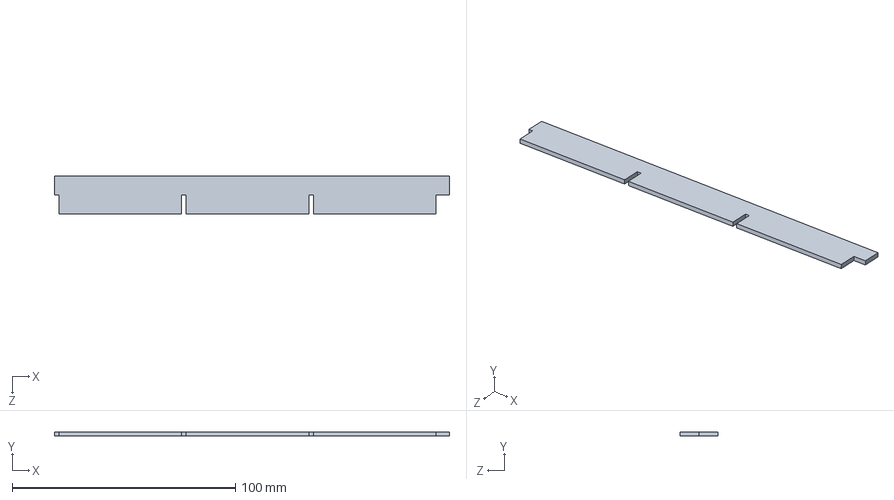
[picture p83: CAD file, 2026-07-26]
航模设计Vcs_4.0/航模设计Vcs_4.0/垂直尾翼/第一横梁.SLDPRT
177.0 x 2.00 x 17.1 mm
