Photo-Finish/aviation-model/闪击莫斯科/cx突然又有招了.dxf

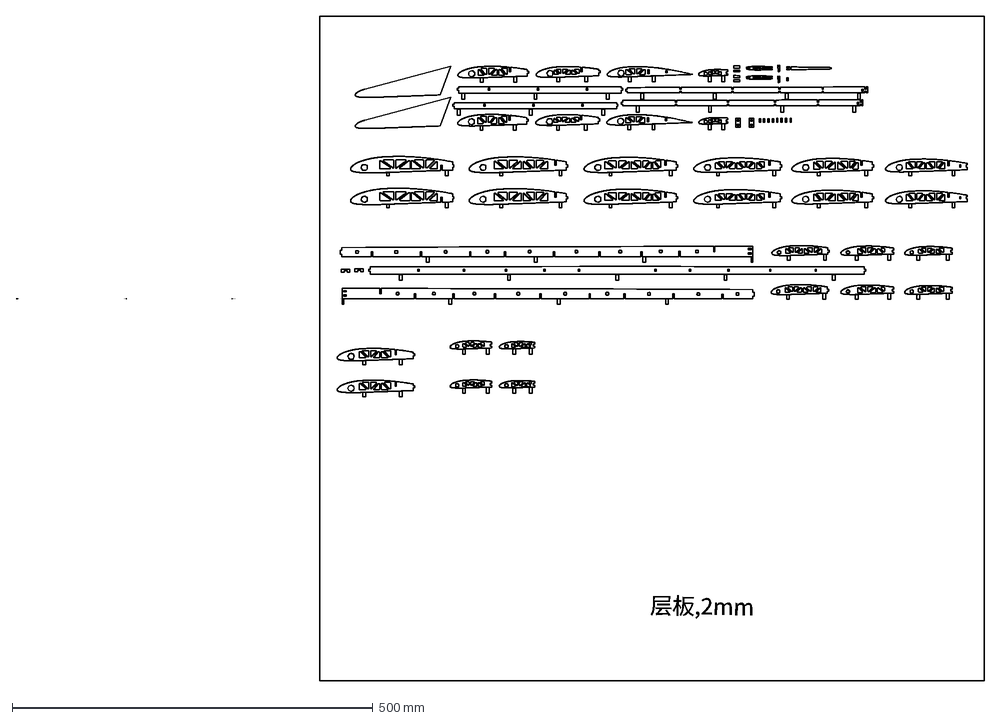
[picture p84: CAD file, 2026-07-26]
闪击莫斯科/cx突然又有招了.dxf
层板,2mm
