Photo-Finish/aviation-model/飞机元器件拆解/飞机元器件拆解/激光切割/垂直尾翼/fin__第一翼肋_高度为59.DXF

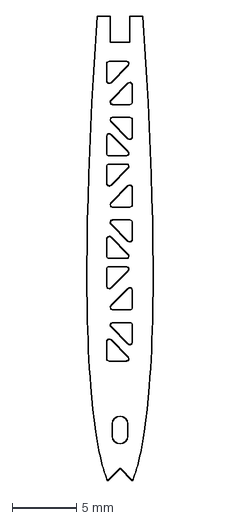
[picture p85: CAD file, 2026-07-26]
飞机元器件拆解/飞机元器件拆解/激光切割/垂直尾翼/fin__第一翼肋_高度为59.DXF
5.16 x 36.2 mm
