Photo-Finish/aviation-model/飞机元器件拆解/飞机元器件拆解/激光切割/水平尾翼/tail_第五块翼肋.DXF

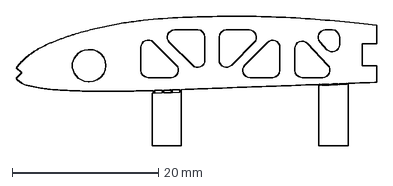
[picture p86: CAD file, 2026-07-26]
飞机元器件拆解/飞机元器件拆解/激光切割/水平尾翼/tail_第五块翼肋.DXF
49.3 x 17.7 mm
