Photo-Finish/aviation-model/Apr. mod/engine mount, print.STEP

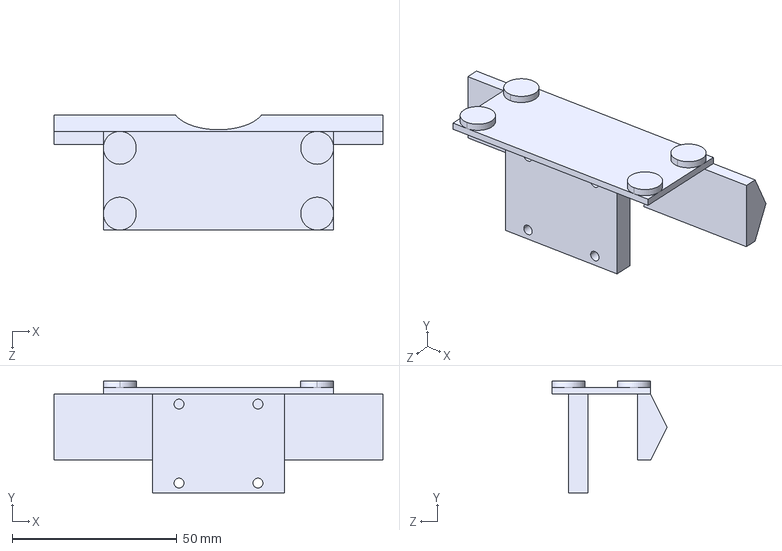
[picture p87: CAD file, 2026-07-26]
Apr. mod/engine mount, print.STEP
100.0 x 34.0 x 35.0 mm
