Photo-Finish/aviation-model/Fuselage/engine stand.SLDPRT

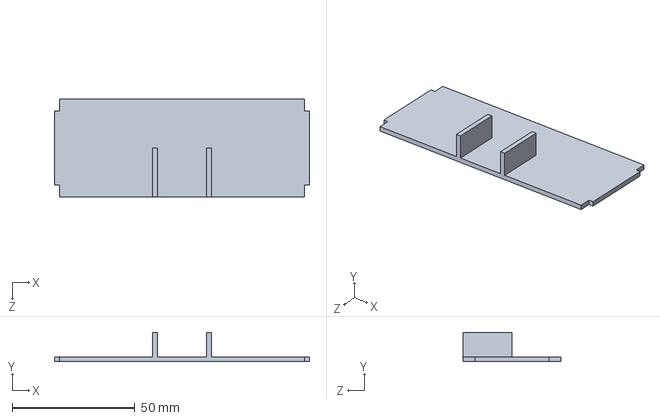
[picture p88: CAD file, 2026-07-26]
Fuselage/engine stand.SLDPRT
104.0 x 12.0 x 40.0 mm
