Photo-Finish/aviation-model/水平尾翼/水平尾翼/第六块翼肋.SLDPRT

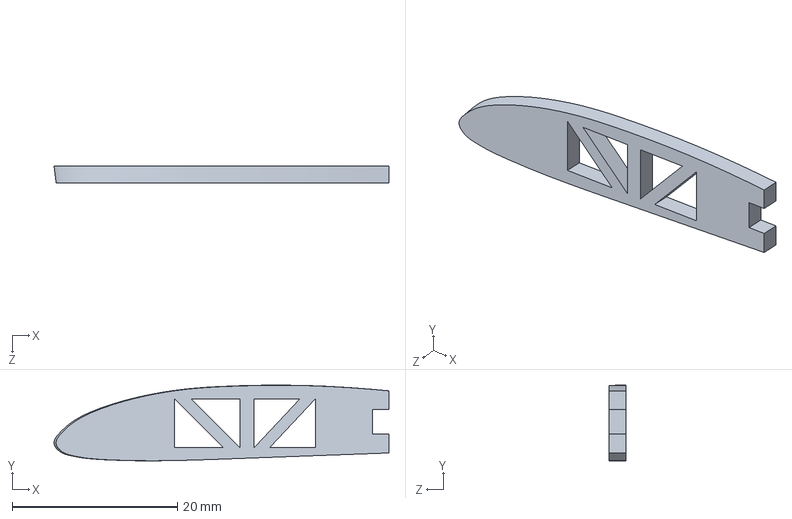
[picture p89: CAD file, 2026-07-26]
水平尾翼/水平尾翼/第六块翼肋.SLDPRT
40.5 x 9.17 x 2.00 mm
