Photo-Finish/aviation-model/航模设计Vcs_4.0/航模设计Vcs_4.0/垂直尾翼/翼肋.SLDPRT

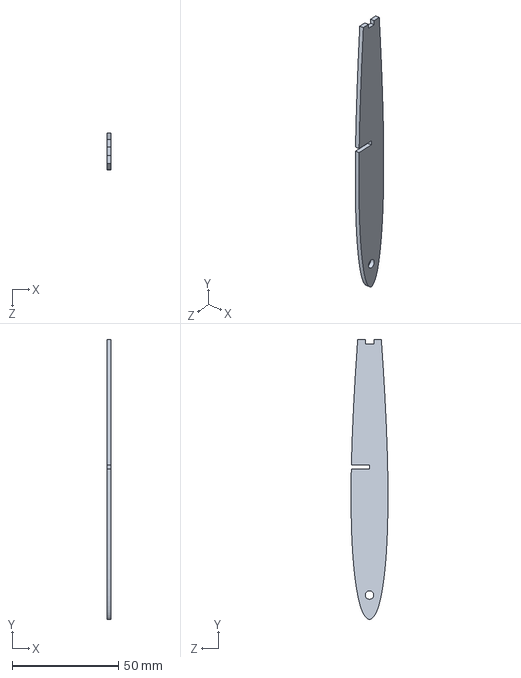
[picture p90: CAD file, 2026-07-26]
航模设计Vcs_4.0/航模设计Vcs_4.0/垂直尾翼/翼肋.SLDPRT
2.00 x 131.7 x 17.4 mm
