Photo-Finish/aviation-model/航模设计Vcs_4.0/航模设计Vcs_4.0/水平尾翼/tail_第一块翼肋.SLDPRT

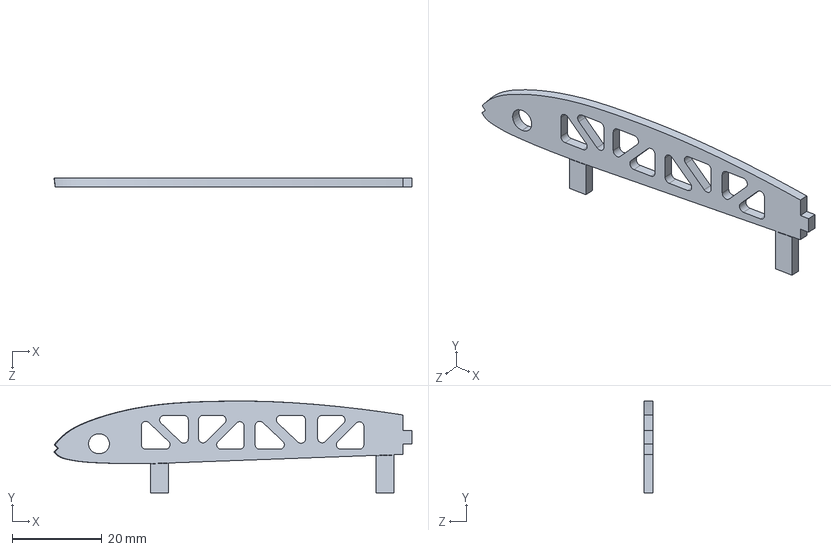
[picture p91: CAD file, 2026-07-26]
航模设计Vcs_4.0/航模设计Vcs_4.0/水平尾翼/tail_第一块翼肋.SLDPRT
79.7 x 20.5 x 2.00 mm
