Photo-Finish/aviation-model/跑CFD的主机翼(只有一半).SLDPRT

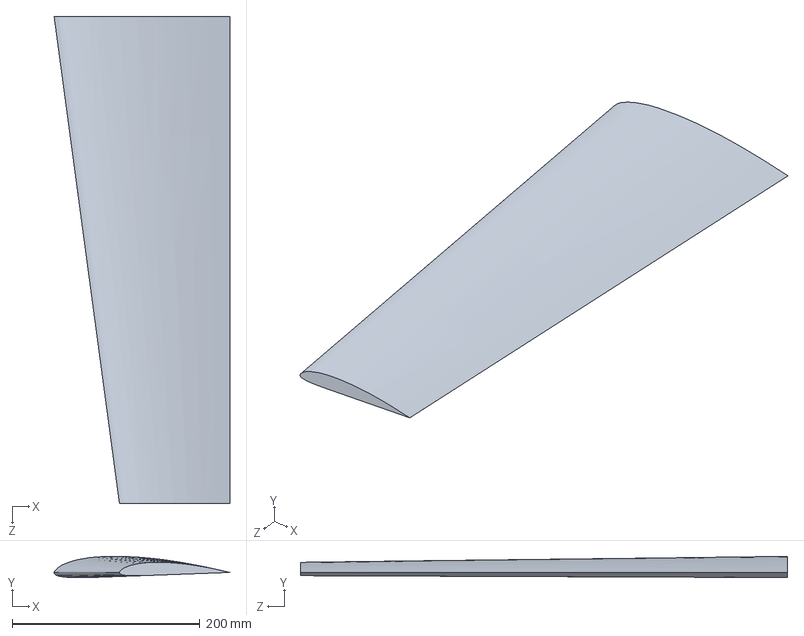
[picture p92: CAD file, 2026-07-26]
跑CFD的主机翼(只有一半).SLDPRT
187.3 x 22.7 x 519.0 mm
