Photo-Finish/aviation-model/闪击莫斯科/test.DXF

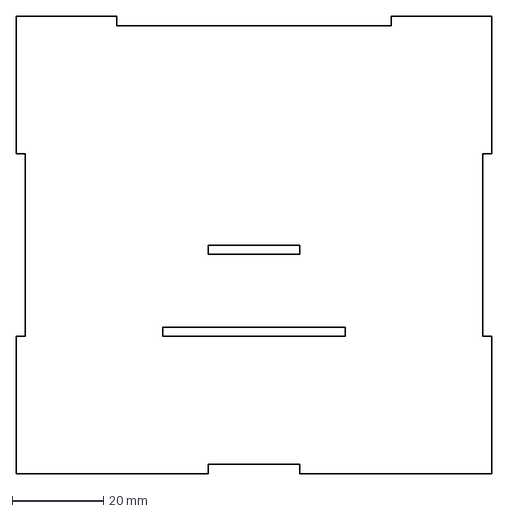
[picture p93: CAD file, 2026-07-26]
闪击莫斯科/test.DXF
104.0 x 100.0 mm
