Photo-Finish/aviation-model/飞机元器件拆解/飞机元器件拆解/3D打印/副翼.STEP

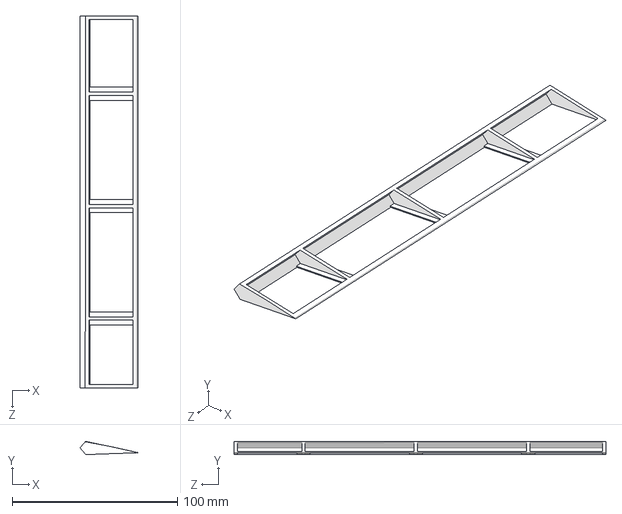
[picture p94: CAD file, 2026-07-26]
飞机元器件拆解/飞机元器件拆解/3D打印/副翼.STEP
35.0 x 8.00 x 225.0 mm
