Photo-Finish/aviation-model/飞机元器件拆解/飞机元器件拆解/激光切割/垂直尾翼/fin_第二翼肋_高度为59.DXF

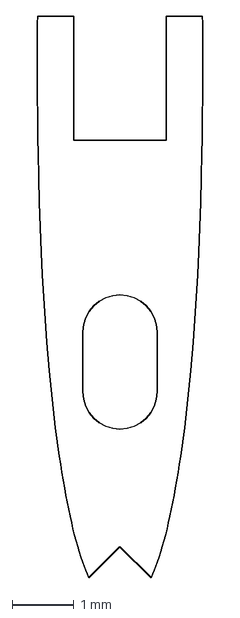
[picture p95: CAD file, 2026-07-26]
飞机元器件拆解/飞机元器件拆解/激光切割/垂直尾翼/fin_第二翼肋_高度为59.DXF
2.67 x 9.07 mm
