Photo-Finish/aviation-model/飞机元器件拆解/飞机元器件拆解/激光切割/水平尾翼/升降舵前挡板.DXF

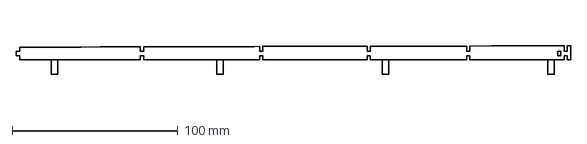
[picture p96: CAD file, 2026-07-26]
飞机元器件拆解/飞机元器件拆解/激光切割/水平尾翼/升降舵前挡板.DXF
335.0 x 17.1 mm
