Photo-Finish/aviation-model/Fuselage/side panel.SLDPRT

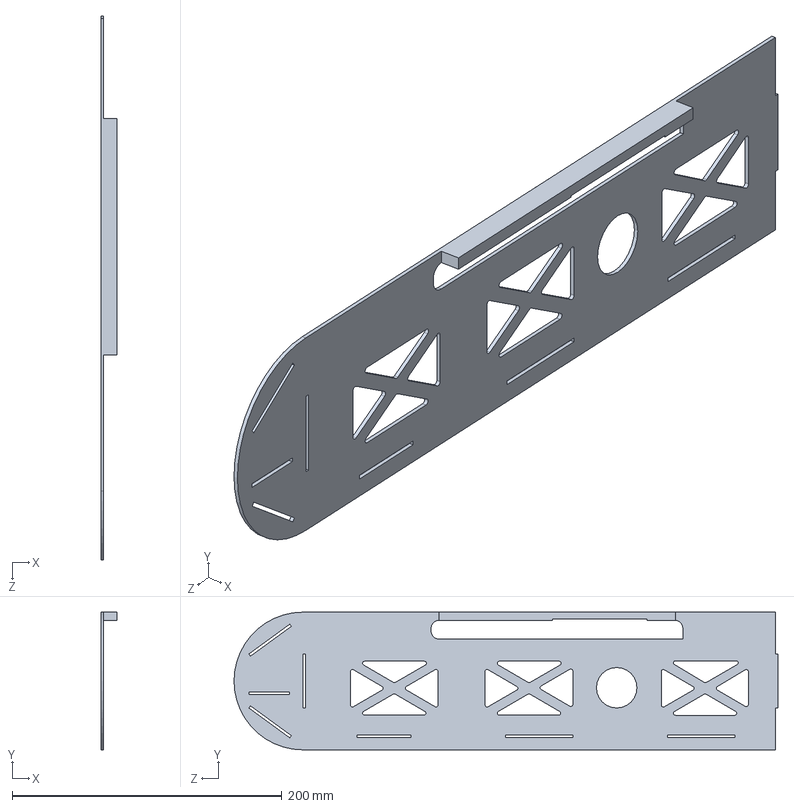
[picture p97: CAD file, 2026-07-26]
Fuselage/side panel.SLDPRT
12.0 x 102.0 x 403.0 mm
