Photo-Finish/aviation-model/主机翼.SLDPRT

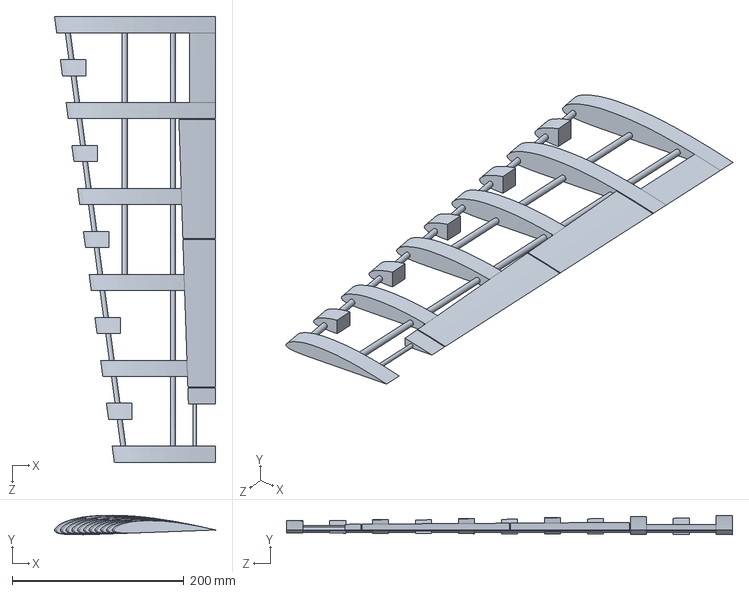
[picture p98: CAD file, 2026-07-26]
主机翼.SLDPRT
187.3 x 22.7 x 519.0 mm
