Photo-Finish/aviation-model/垂直尾翼/垂直尾翼/方向舵.SLDPRT

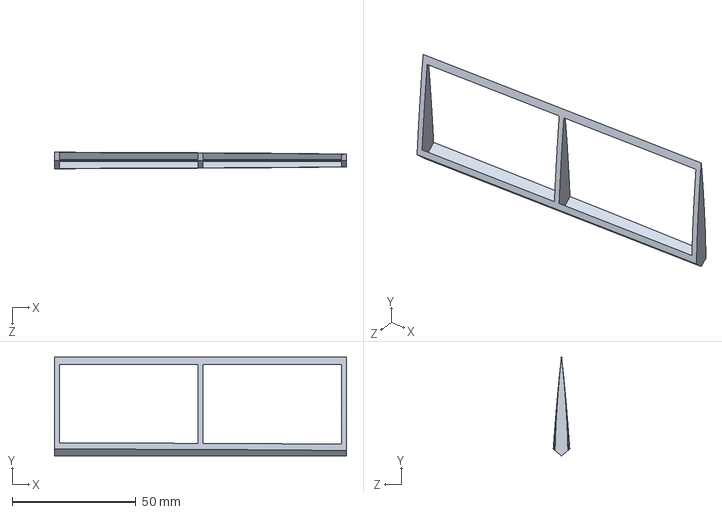
[picture p99: CAD file, 2026-07-26]
垂直尾翼/垂直尾翼/方向舵.SLDPRT
118.0 x 40.0 x 6.72 mm
