Photo-Finish/aviation-model/航模设计Vcs_4.0/航模设计Vcs_4.0/垂直尾翼/第二横梁.SLDPRT

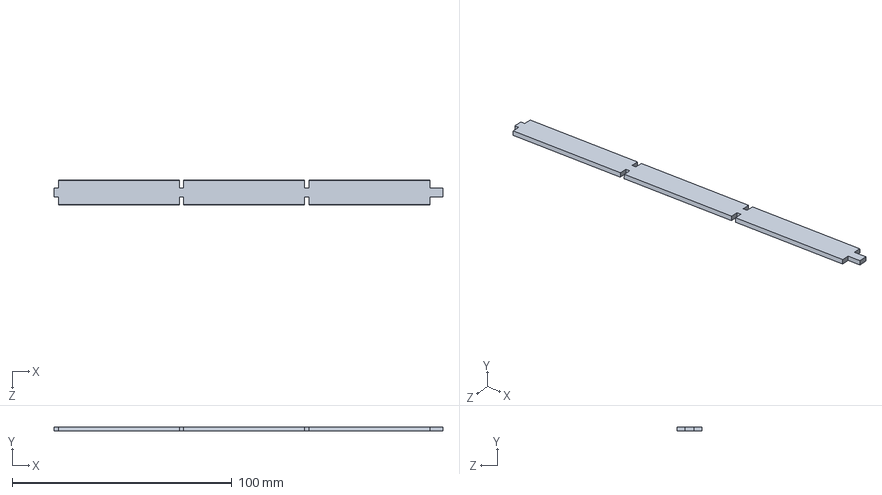
[picture p100: CAD file, 2026-07-26]
航模设计Vcs_4.0/航模设计Vcs_4.0/垂直尾翼/第二横梁.SLDPRT
177.0 x 2.00 x 11.4 mm
