Photo-Finish/aviation-model/飞机元器件拆解/飞机元器件拆解/激光切割/主机翼/副翼前挡板.DXF

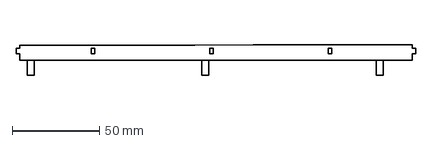
[picture p101: CAD file, 2026-07-26]
飞机元器件拆解/飞机元器件拆解/激光切割/主机翼/副翼前挡板.DXF
229.0 x 17.4 mm
