Photo-Finish/aviation-model/飞机元器件拆解/飞机元器件拆解/激光切割/水平尾翼/tail_第四块翼肋.DXF

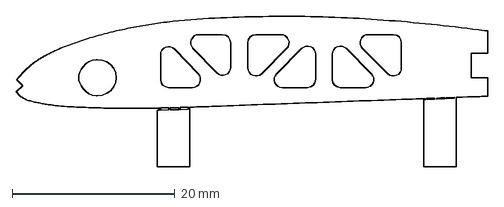
[picture p102: CAD file, 2026-07-26]
飞机元器件拆解/飞机元器件拆解/激光切割/水平尾翼/tail_第四块翼肋.DXF
58.0 x 18.5 mm
