Photo-Finish/aviation-model/Fuselage/side panel fuck.SLDPRT

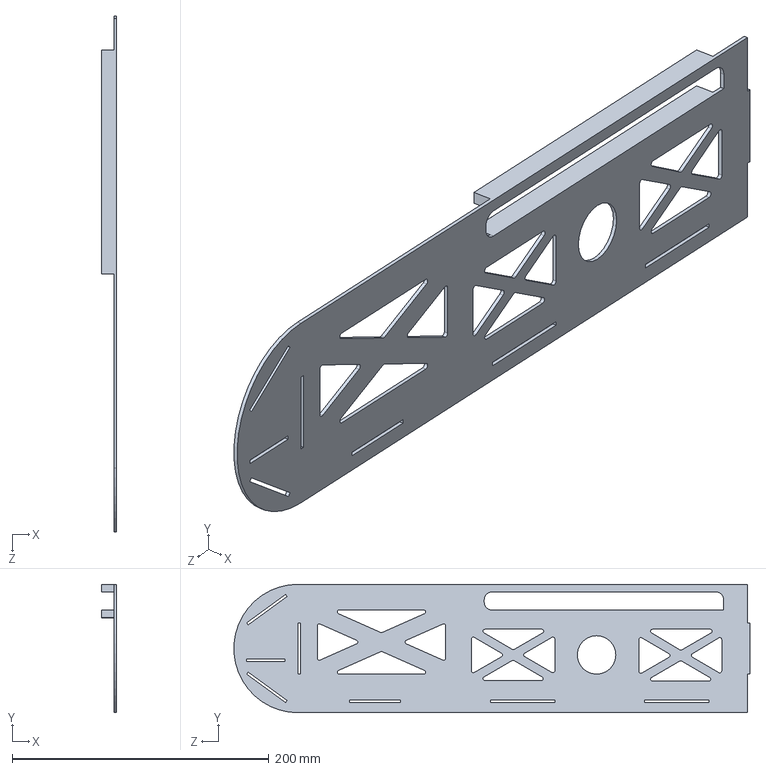
[picture p103: CAD file, 2026-07-26]
Fuselage/side panel fuck.SLDPRT
12.0 x 100.0 x 401.9 mm
