Photo-Finish/aviation-model/垂直尾翼/垂直尾翼/方向舵前横梁.SLDPRT

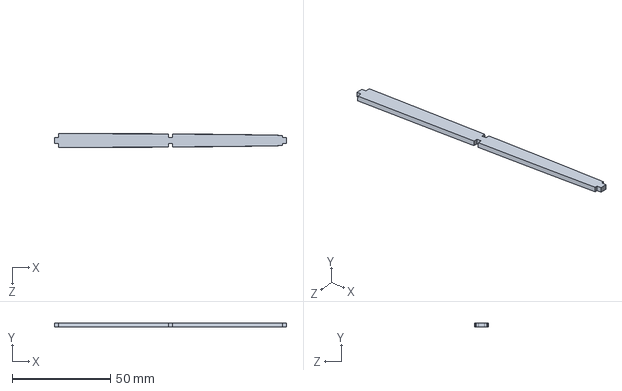
[picture p104: CAD file, 2026-07-26]
垂直尾翼/垂直尾翼/方向舵前横梁.SLDPRT
118.0 x 2.00 x 7.36 mm
