Photo-Finish/aviation-model/水平尾翼/水平尾翼/第二块翼肋.SLDPRT

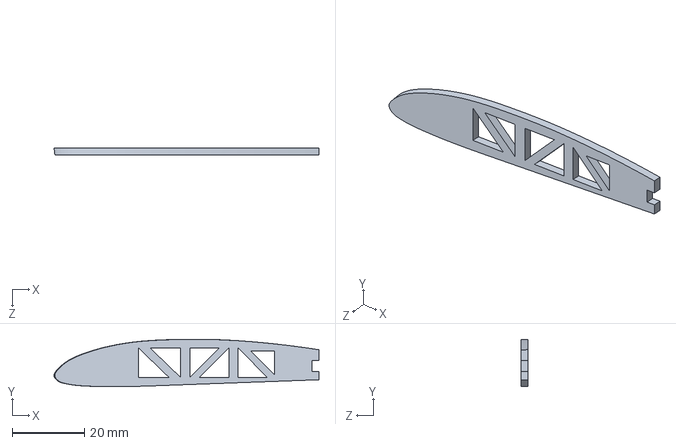
[picture p105: CAD file, 2026-07-26]
水平尾翼/水平尾翼/第二块翼肋.SLDPRT
73.3 x 13.1 x 2.00 mm
