Photo-Finish/aviation-model/飞机元器件拆解/飞机元器件拆解/激光切割/水平尾翼/tail_卡扣.DXF

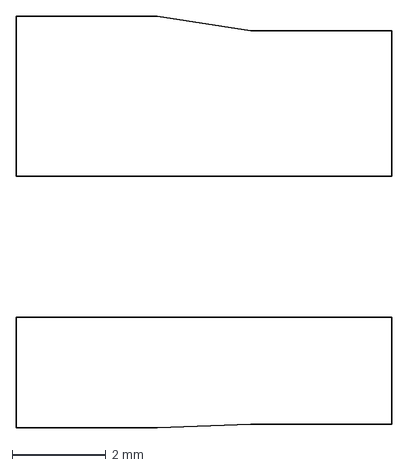
[picture p106: CAD file, 2026-07-26]
飞机元器件拆解/飞机元器件拆解/激光切割/水平尾翼/tail_卡扣.DXF
8.00 x 8.78 mm
