Photo-Finish/aviation-model/主机翼/主机翼/襟翼前龙骨挡板.SLDPRT

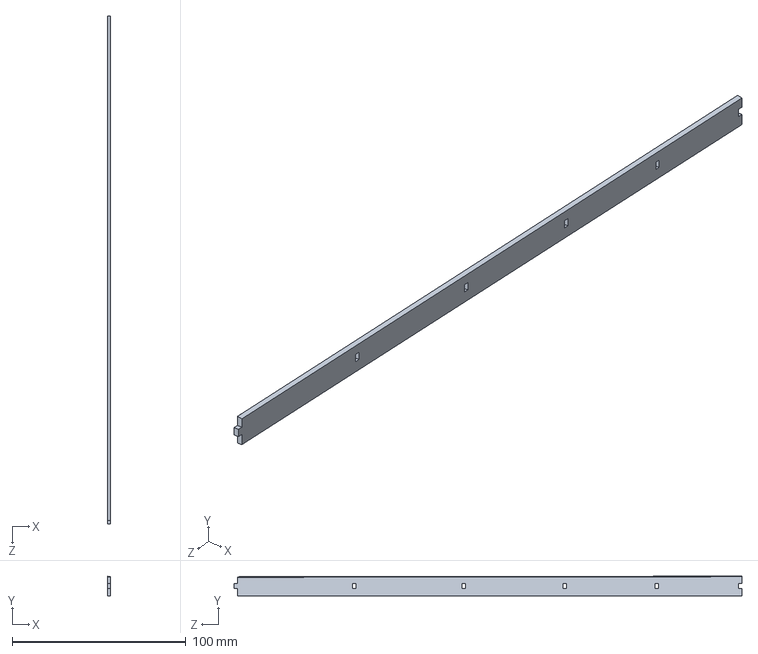
[picture p107: CAD file, 2026-07-26]
主机翼/主机翼/襟翼前龙骨挡板.SLDPRT
2.00 x 11.4 x 292.0 mm
