Photo-Finish/aviation-model/水平尾翼/水平尾翼/升降舵.SLDPRT

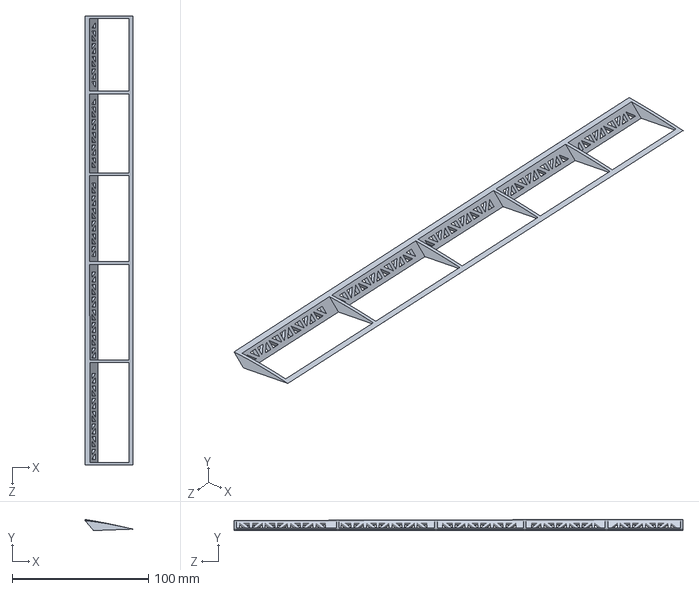
[picture p108: CAD file, 2026-07-26]
水平尾翼/水平尾翼/升降舵.SLDPRT
35.0 x 8.17 x 329.0 mm
