Photo-Finish/aviation-model/跑CFD的水平尾翼(对称两侧).SLDPRT

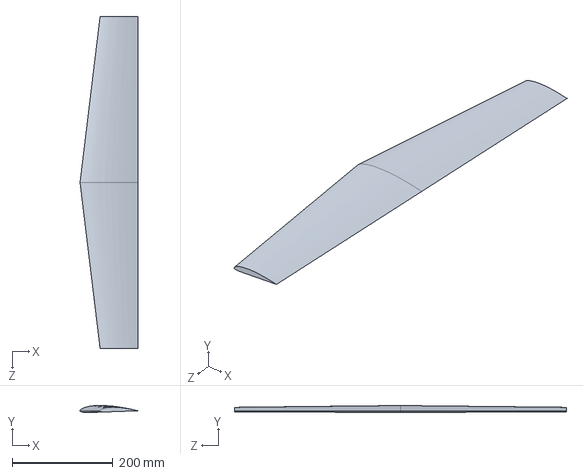
[picture p109: CAD file, 2026-07-26]
跑CFD的水平尾翼(对称两侧).SLDPRT
114.9 x 13.8 x 658.0 mm
