Photo-Finish/aviation-model/飞机元器件拆解/飞机元器件拆解/3D打印/fin_方向舵_高度为59.STEP

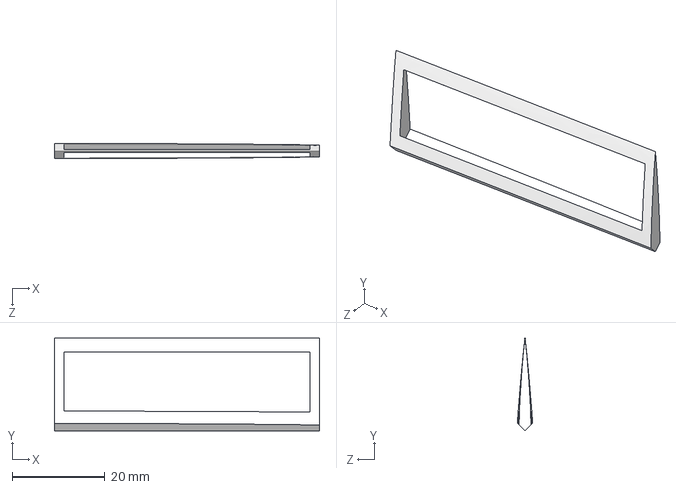
[picture p110: CAD file, 2026-07-26]
飞机元器件拆解/飞机元器件拆解/3D打印/fin_方向舵_高度为59.STEP
57.0 x 20.0 x 3.33 mm
