Photo-Finish/aviation-model/飞机元器件拆解/飞机元器件拆解/激光切割/水平尾翼/tail_第三块翼肋.DXF

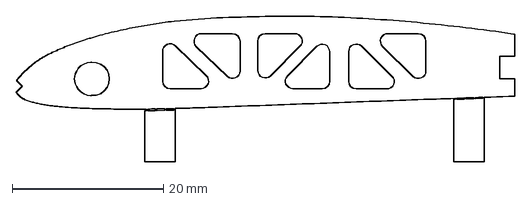
[picture p111: CAD file, 2026-07-26]
飞机元器件拆解/飞机元器件拆解/激光切割/水平尾翼/tail_第三块翼肋.DXF
65.8 x 19.2 mm
