Photo-Finish/aviation-model/Fuselage/tail rear wall.SLDPRT

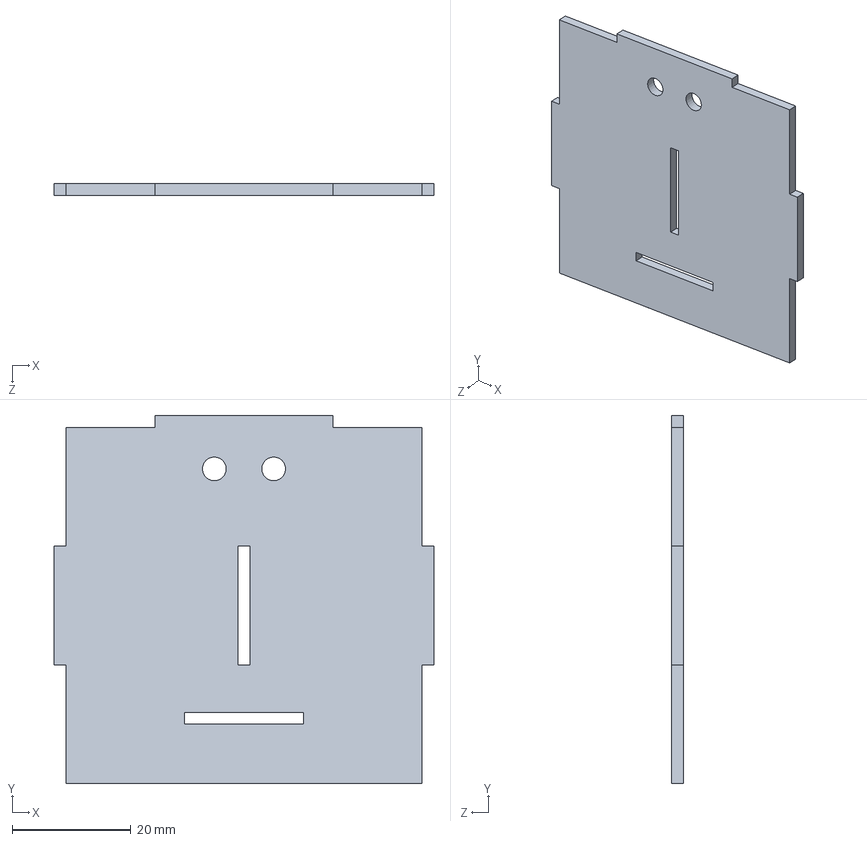
[picture p112: CAD file, 2026-07-26]
Fuselage/tail rear wall.SLDPRT
64.0 x 62.0 x 2.00 mm
