Photo-Finish/aviation-model/主机翼/主机翼/襟翼.SLDPRT

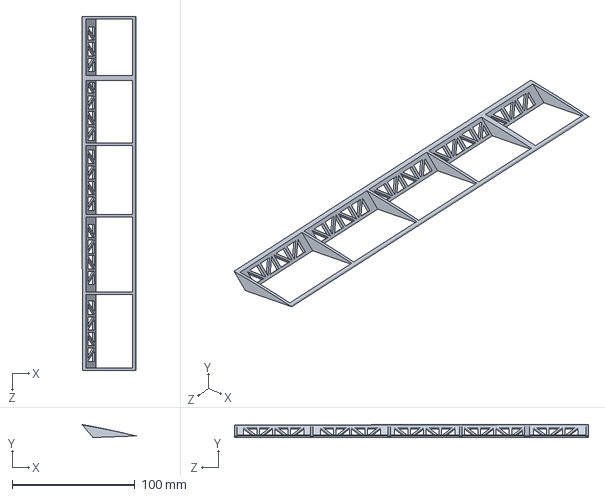
[picture p113: CAD file, 2026-07-26]
主机翼/主机翼/襟翼.SLDPRT
44.0 x 10.6 x 288.0 mm
