Photo-Finish/aviation-model/垂直尾翼/垂直尾翼/第一横梁.SLDPRT

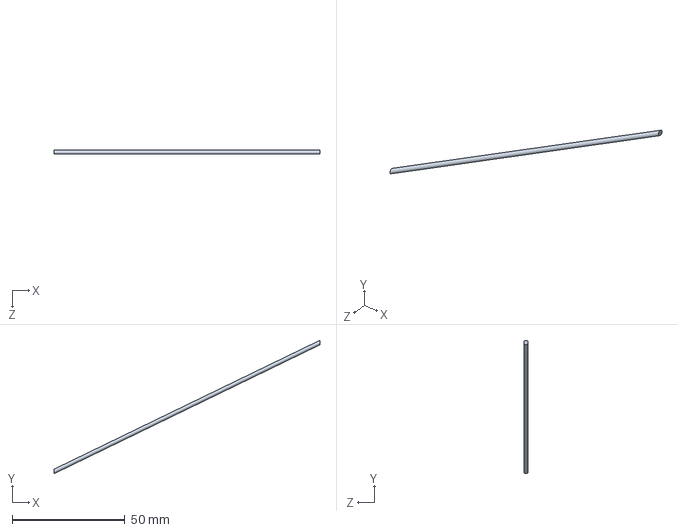
[picture p114: CAD file, 2026-07-26]
垂直尾翼/垂直尾翼/第一横梁.SLDPRT
118.0 x 59.2 x 1.99 mm
