Photo-Finish/aviation-model/水平尾翼/水平尾翼/第四块翼肋.SLDPRT

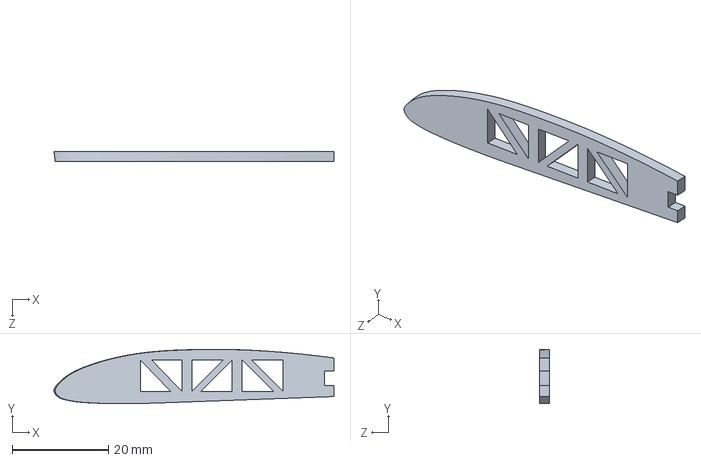
[picture p115: CAD file, 2026-07-26]
水平尾翼/水平尾翼/第四块翼肋.SLDPRT
58.2 x 11.3 x 2.00 mm
