Photo-Finish/aviation-model/Fuselage/windshear.SLDPRT

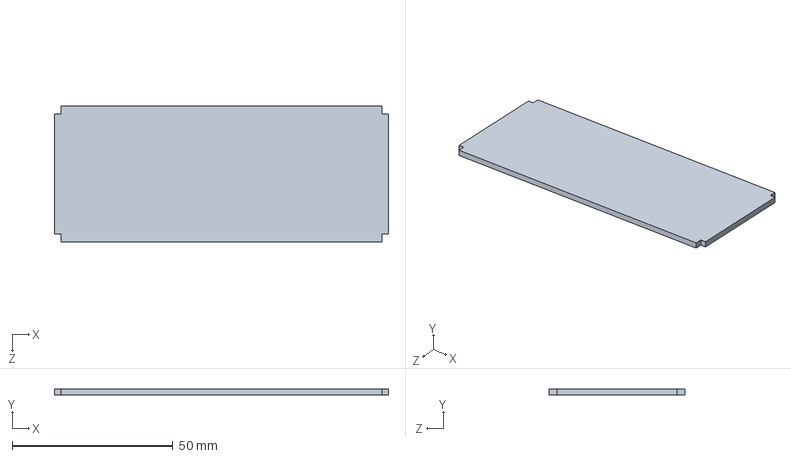
[picture p117: CAD file, 2026-07-26]
Fuselage/windshear.SLDPRT
104.0 x 2.00 x 42.5 mm
