Photo-Finish/aviation-model/垂直尾翼/垂直尾翼/第一翼肋.SLDPRT

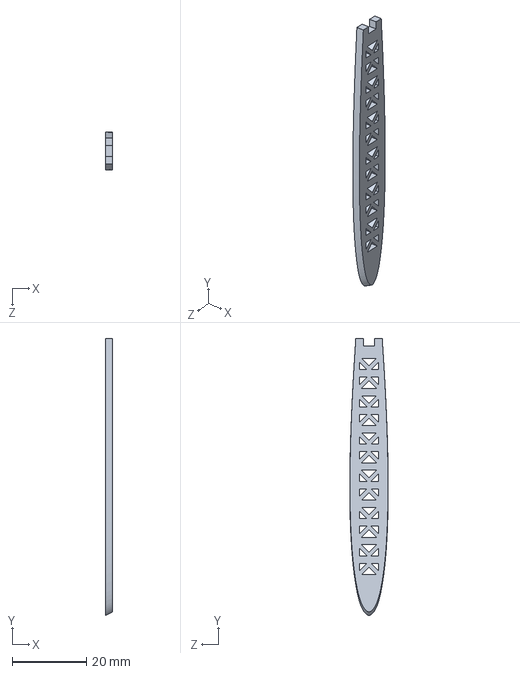
[picture p118: CAD file, 2026-07-26]
垂直尾翼/垂直尾翼/第一翼肋.SLDPRT
2.00 x 74.4 x 10.3 mm
