Photo-Finish/aviation-model/水平尾翼/水平尾翼/半径为2mm的碳纤维棒.SLDPRT

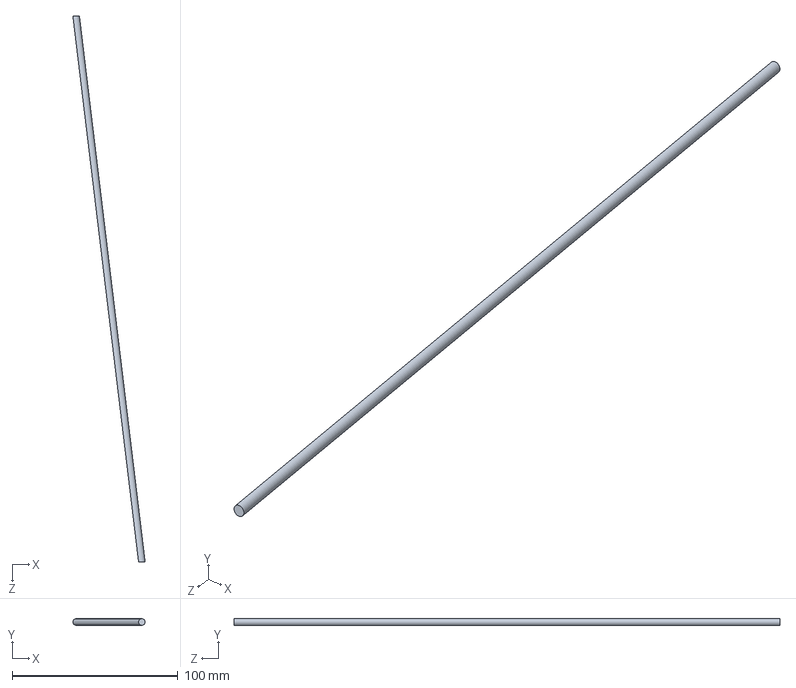
[picture p119: CAD file, 2026-07-26]
水平尾翼/水平尾翼/半径为2mm的碳纤维棒.SLDPRT
43.6 x 3.98 x 329.0 mm
