Photo-Finish/aviation-model/航模设计Vcs_4.0/航模设计Vcs_4.0/垂直尾翼/装配体.SLDASM

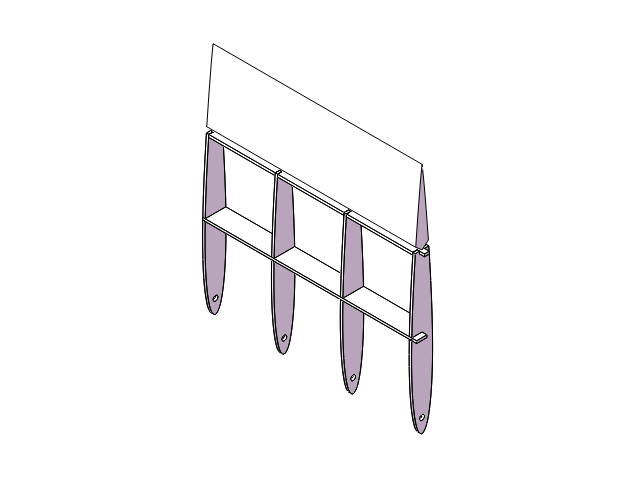
[picture p120: CAD file, 2026-07-26]
航模设计Vcs_4.0/航模设计Vcs_4.0/垂直尾翼/装配体.SLDASM
翼肋 x 4
第二横梁
第一横梁
方向舵
