Photo-Finish/aviation-model/主机翼/主机翼/A_main_主机翼装配.SLDASM

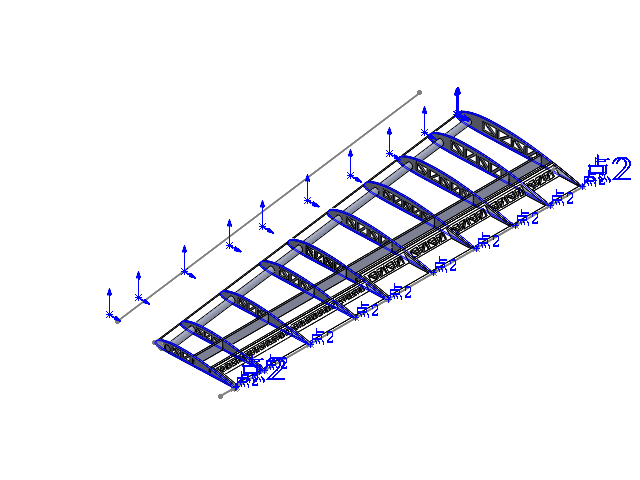
[picture p121: CAD file, 2026-07-26]
主机翼/主机翼/A_main_主机翼装配.SLDASM
第一块翼肋
第二块翼肋
第三块翼肋
第四块翼肋
第五块翼肋
第六块翼肋
第七块翼肋
第八块翼肋
第九块翼肋
第十块翼肋
第二横梁
襟翼前龙骨挡板
副翼前挡板
第一横梁
襟翼
引导塑料薄膜附着
副翼
