Photo-Finish/aviation-model/垂直尾翼/垂直尾翼/A_main_垂直尾翼.SLDASM

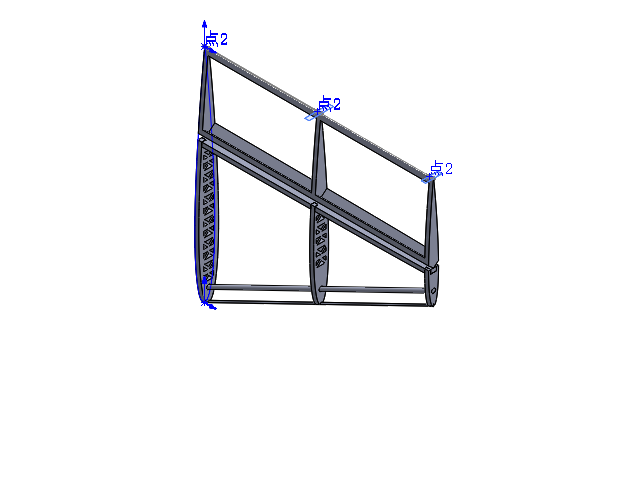
[picture p122: CAD file, 2026-07-26]
垂直尾翼/垂直尾翼/A_main_垂直尾翼.SLDASM
第一翼肋
第二翼肋
第三翼肋
方向舵前横梁
塑料薄膜附着处
第一横梁
方向舵
