Photo-Finish/aviation-model/航模设计Vcs_4.0/航模设计Vcs_4.0/水平尾翼/A_main_水平尾翼.SLDASM

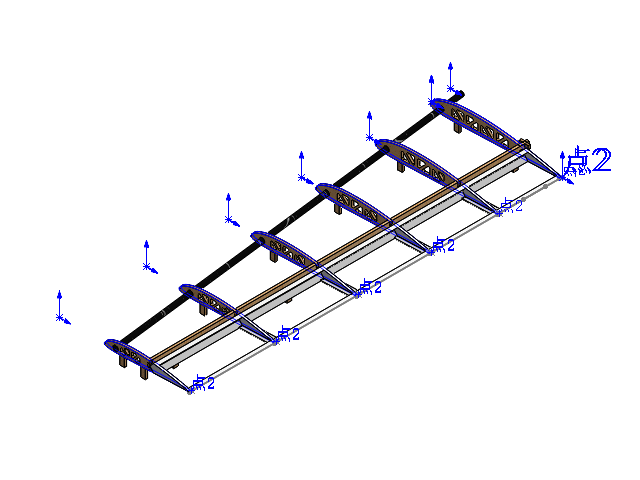
[picture p123: CAD file, 2026-07-26]
航模设计Vcs_4.0/航模设计Vcs_4.0/水平尾翼/A_main_水平尾翼.SLDASM
tail_第一块翼肋
tail_第二块翼肋
tail_第三块翼肋
tail_第四块翼肋
tail_第五块翼肋
tail_第六块翼肋
升降舵
半径为2mm的碳纤维棒
升降舵前挡板
tail_卡扣
