Photo-Finish/aviation-model/乌拉！.SLDASM

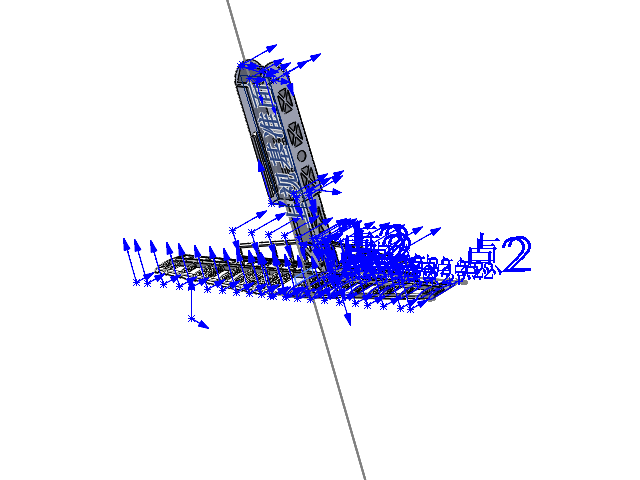
[picture p124: CAD file, 2026-07-26]
乌拉！.SLDASM
windshear vertical
windshear
engine stand
connexion panel
tail ceiling
tail rear wall
tail side x 2
tail floor
side panel - fuck so shit - 副本
side panel - fuck so shit
floor
ceiling
tail ceiling panel
main_wing_第一块翼肋
main_wing_第二块翼肋
main_wing_第三块翼肋
main_wing_第四块翼肋
main_wing_第五块翼肋
main_wing_第六块翼肋
main_wing_第七块翼肋
main_wing_第八块翼肋
main_wing_第九块翼肋
main_wing_第十块翼肋
副翼前挡板
襟翼
main_wing_引导塑料薄膜附着
副翼
Mirrormain_wing_第一块翼肋
Mirrormain_wing_第二块翼肋
Mirrormain_wing_第三块翼肋
Mirrormain_wing_第四块翼肋
Mirrormain_wing_第五块翼肋
Mirrormain_wing_第六块翼肋
Mirrormain_wing_第七块翼肋
Mirrormain_wing_第八块翼肋
Mirrormain_wing_第九块翼肋
Mirrormain_wing_第十块翼肋
Mirrormain_wing_副翼前挡板
Mirror襟翼
Mirror引导塑料薄膜附着
Mirror副翼
main_wing_第二横梁
main_wing_第一横梁
Mirrormain_wing_第一横梁
襟翼前龙骨挡板
tail_第一块翼肋
tail_第二块翼肋
tail_第三块翼肋
tail_第四块翼肋
tail_第五块翼肋
tail_第六块翼肋
tail_塑料薄膜附着位点
升降舵
半径为2mm的碳纤维棒
升降舵前挡板
tail_卡扣
Mirrortail_第一块翼肋
Mirrortail_第二块翼肋
Mirrortail_第三块翼肋
Mirrortail_第四块翼肋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
