Photo-Finish/aviation-model/水平尾翼/水平尾翼/A_main_水平尾翼.SLDASM

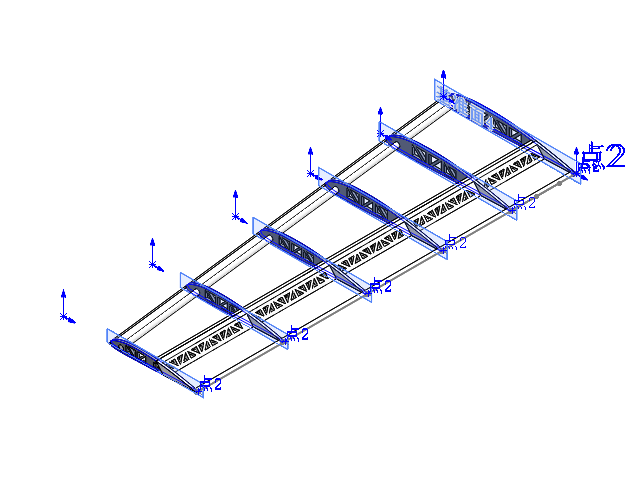
[picture p125: CAD file, 2026-07-26]
水平尾翼/水平尾翼/A_main_水平尾翼.SLDASM
第一块翼肋
第二块翼肋
第三块翼肋
第四块翼肋
第五块翼肋
第六块翼肋
升降舵前挡板
半径为2mm的碳纤维棒
塑料薄膜附着位点
升降舵
