Photo-Finish/aviation-model/航模设计Vcs_4.0/航模设计Vcs_4.0/参考设计.SLDASM

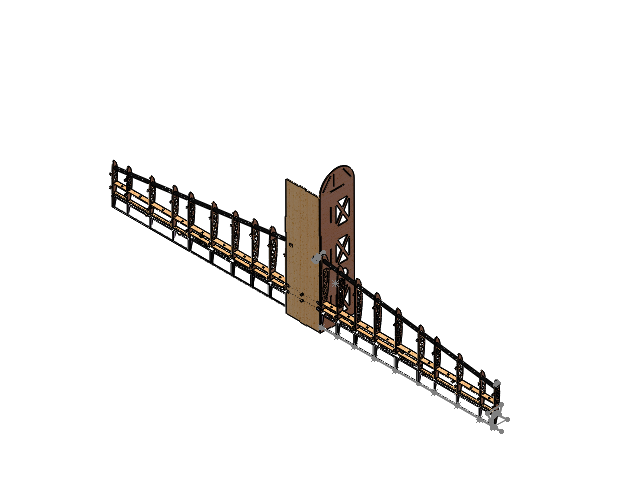
[picture p126: CAD file, 2026-07-26]
航模设计Vcs_4.0/航模设计Vcs_4.0/参考设计.SLDASM
4_0_gear mount
main_wing_第一块翼肋
main_wing_第二块翼肋
main_wing_第三块翼肋
main_wing_第四块翼肋
main_wing_第五块翼肋
main_wing_第六块翼肋
main_wing_第七块翼肋
main_wing_第八块翼肋
main_wing_第九块翼肋
main_wing_第十块翼肋
副翼前挡板
襟翼
副翼
Mirrormain_wing_第一块翼肋
Mirrormain_wing_第二块翼肋
Mirrormain_wing_第三块翼肋
Mirrormain_wing_第四块翼肋
Mirrormain_wing_第五块翼肋
Mirrormain_wing_第六块翼肋
Mirrormain_wing_第七块翼肋
Mirrormain_wing_第八块翼肋
Mirrormain_wing_第九块翼肋
Mirrormain_wing_第十块翼肋
Mirrormain_wing_副翼前挡板
Mirror襟翼
Mirror副翼
main_wing_第二横梁
main_wing_第一横梁
Mirrormain_wing_第一横梁
襟翼前龙骨挡板
4_0_side panel - fuck so shit
主机翼碳棒固定件 (2)
主机翼碳棒固定件 (3)
主机翼碳棒固定件 (4)
主机翼碳棒固定件 (5)
主机翼第一横梁固定件 x 4
主机翼第二横梁固定件
