Photo-Finish/aviation-model/Fuselage/fuselage.SLDASM

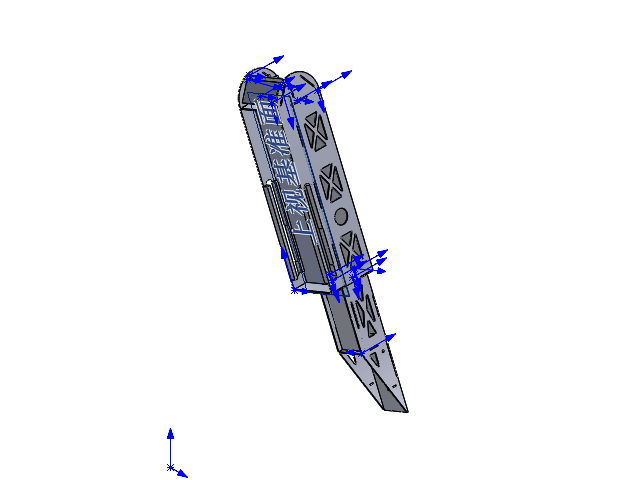
[picture p127: CAD file, 2026-07-26]
Fuselage/fuselage.SLDASM
windshear vertical
windshear
engine stand
connexion panel
tail ceiling
tail rear wall
tail side x 2
tail floor
side panel - fuck so shit - 副本
side panel - fuck so shit
floor
ceiling
tail ceiling panel
