Photo-Finish/aviation-model/航模设计Vcs_4.0/航模设计Vcs_4.0/主机翼/主机翼联合体.SLDASM

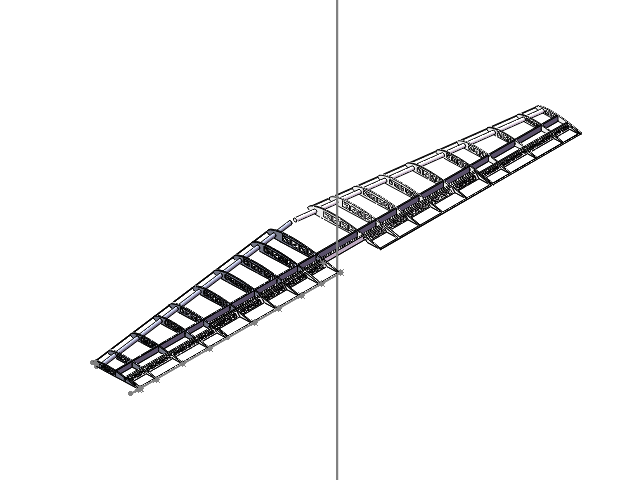
[picture p128: CAD file, 2026-07-26]
航模设计Vcs_4.0/航模设计Vcs_4.0/主机翼/主机翼联合体.SLDASM
main_wing_第一块翼肋
main_wing_第二块翼肋
main_wing_第三块翼肋
main_wing_第四块翼肋
main_wing_第五块翼肋
main_wing_第六块翼肋
main_wing_第七块翼肋
main_wing_第八块翼肋
main_wing_第九块翼肋
main_wing_第十块翼肋
副翼前挡板
襟翼
副翼
Mirrormain_wing_第一块翼肋
Mirrormain_wing_第二块翼肋
Mirrormain_wing_第三块翼肋
Mirrormain_wing_第四块翼肋
Mirrormain_wing_第五块翼肋
Mirrormain_wing_第六块翼肋
Mirrormain_wing_第七块翼肋
Mirrormain_wing_第八块翼肋
Mirrormain_wing_第九块翼肋
Mirrormain_wing_第十块翼肋
Mirrormain_wing_副翼前挡板
Mirror襟翼
Mirror副翼
main_wing_第二横梁
main_wing_第一横梁
Mirrormain_wing_第一横梁
襟翼前龙骨挡板
