Photo-Finish/aviation-model/(list of files, cad)

Other CAD files:
航模设计Vcs_4.0/航模设计Vcs_4.0/主机翼/Mirrormain_wing_第三块翼肋.SLDPRT
航模设计Vcs_4.0/航模设计Vcs_4.0/主机翼/Mirrormain_wing_第七块翼肋.SLDPRT
航模设计Vcs_4.0/航模设计Vcs_4.0/主机翼/Mirrormain_wing_第一横梁.SLDPRT
航模设计Vcs_4.0/航模设计Vcs_4.0/主机翼/Mirrormain_wing_第六块翼肋.SLDPRT
航模设计Vcs_4.0/航模设计Vcs_4.0/水平尾翼/MirrorA_main_水平尾翼.SLDASM
航模设计Vcs_4.0/航模设计Vcs_4.0/主机翼/Mirrormain_wing_第八块翼肋.SLDPRT
航模设计Vcs_4.0/航模设计Vcs_4.0/主机翼/Mirrormain_wing_第一块翼肋.SLDPRT
航模设计Vcs_4.0/航模设计Vcs_4.0/主机翼/Mirrormain_wing_第四块翼肋.SLDPRT
航模设计Vcs_4.0/航模设计Vcs_4.0/主机翼/Mirrormain_wing_第二块翼肋.SLDPRT
航模设计Vcs_4.0/航模设计Vcs_4.0/主机翼/Mirrormain_wing_副翼前挡板.SLDPRT
航模设计Vcs_4.0/航模设计Vcs_4.0/主机翼/Mirrormain_wing_第五块翼肋.SLDPRT
航模设计Vcs_4.0/航模设计Vcs_4.0/主机翼/Mirrormain_wing_平面版小翼_可以是木板.SLDPRT
航模设计Vcs_4.0/航模设计Vcs_4.0/主机翼/Mirrormain_wing_第十块翼肋.SLDPRT
航模设计Vcs_4.0/航模设计Vcs_4.0/主机翼/MirrorA_main_主机翼装配.SLDASM
航模设计Vcs_4.0/航模设计Vcs_4.0/主机翼/Mirrormain_wing_第九块翼肋.SLDPRT
正式版/FIN2, mod.dxf
航模设计Vcs_4.0/航模设计Vcs_4.0/水平尾翼/Mirrortail_卡扣.SLDPRT
闪击莫斯科/第三个tile_第二横梁拆分及对应的两个卡扣_襟翼前挡板_水平尾翼翼肋1-5.DXF
主机翼/主机翼/第三块翼肋.SLDPRT
闪击莫斯科/第二个tile_翼肋编号8-10_小翼_副翼前挡板_水平尾翼翼肋6_升降舵前挡板_水平尾翼卡扣_垂直尾翼翼肋1-2_方向舵挡板_垂直尾翼卡扣_插座板_插座.DXF
Fuselage/Fuck Everything ~/Fuselage, 2-eme.SLDPRT
航模设计Vcs_4.0/航模设计Vcs_4.0/水平尾翼/Mirrortail_第四块翼肋.SLDPRT
飞机元器件拆解/飞机元器件拆解/3D打印/襟翼.STEP
主机翼/主机翼/第一块翼肋.SLDPRT
垂直尾翼/垂直尾翼/raw_垂直尾翼.SLDPRT
改个锤子！八十！/1.dxf
航模设计Vcs_4.0/航模设计Vcs_4.0/主机翼碳棒固定件_总.SLDPRT
主机翼/主机翼/第六块翼肋.SLDPRT
水平尾翼/水平尾翼/第三块翼肋.SLDPRT
航模设计Vcs_4.0/航模设计Vcs_4.0/主机翼碳棒固定件 (5).SLDPRT
航模设计Vcs_4.0/航模设计Vcs_4.0/水平尾翼/tail_塑料薄膜附着位点.SLDPRT
飞机元器件拆解/飞机元器件拆解/3D打印/Mirror副翼.STEP
主机翼/主机翼/引导塑料薄膜附着.SLDPRT
航模设计Vcs_4.0/航模设计Vcs_4.0/主机翼第二横梁固定件.SLDPRT
飞机元器件拆解/飞机元器件拆解/3D打印/升降舵.STEP
航模设计Vcs_4.0/航模设计Vcs_4.0/主机翼第一横梁固定件.SLDPRT
航模设计Vcs_4.0/航模设计Vcs_4.0/水平尾翼/Mirror升降舵前挡板.SLDPRT
航模设计Vcs_4.0/航模设计Vcs_4.0/主机翼碳棒固定件 (3).SLDPRT
主机翼/主机翼/第四块翼肋.SLDPRT
航模设计Vcs_4.0/航模设计Vcs_4.0/主机翼第一横梁固定件_总.SLDPRT
航模设计Vcs_4.0/航模设计Vcs_4.0/水平尾翼/升降舵.SLDPRT
Apr. mod/engine mount, floor.DXF
Apr. mod/engine mount, print.SLDPRT
Apr. mod/windshear.DXF
FIN, mod.dxf
Fuselage/Fuck Everything ~/Fuselage - 副本.SLDPRT
Fuselage/Fuck Everything ~/Fuselage.SLDPRT
Fuselage/ceiling.SLDPRT
Fuselage/connexion panel.SLDPRT
Fuselage/floor.SLDPRT
Fuselage/side panel - fuck so shit - 副本.SLDPRT
Fuselage/side panel - fuck so shit.SLDPRT
Fuselage/side panel - 副本.SLDPRT
Fuselage/tail ceiling panel.SLDPRT
Fuselage/tail side.SLDPRT
Fuselage/windshear vertical.SLDPRT
tile deuxeme.dxf
tile premiere.DXF
主机翼/主机翼/主机翼翅根龙骨.SLDPRT
主机翼/主机翼/副翼.SLDPRT
主机翼/主机翼/副翼前挡板.SLDPRT
主机翼/主机翼/水平尾翼.SLDPRT
主机翼/主机翼/碳纤维管.SLDPRT
主机翼/主机翼/第一横梁.SLDPRT
主机翼/主机翼/第七块翼肋.SLDPRT
主机翼/主机翼/第九块翼肋.SLDPRT
主机翼/主机翼/第二块翼肋.SLDPRT
主机翼/主机翼/第五块翼肋.SLDPRT
主机翼/主机翼/第八块翼肋.SLDPRT
主机翼/主机翼/第十块翼肋.SLDPRT
乌拉！ - 副本.SLDASM
垂直尾翼 (2)/垂直尾翼/B_main_垂直尾翼缩放后结果 - 副本.SLDASM
垂直尾翼 (2)/垂直尾翼/B_main_垂直尾翼缩放后结果.SLDASM
垂直尾翼 (2)/垂直尾翼/fin__第一翼肋_高度为59.SLDPRT
垂直尾翼 (2)/垂直尾翼/fin_卡扣_高度为59.SLDPRT
垂直尾翼 (2)/垂直尾翼/fin_塑料薄膜前缘附着位点_高度为59.SLDPRT
垂直尾翼 (2)/垂直尾翼/fin_方向舵_高度为59.SLDPRT
垂直尾翼 (2)/垂直尾翼/fin_方向舵前挡板_高度为59.SLDPRT
垂直尾翼 (2)/垂直尾翼/fin_碳纤维棒直径0.5mm_高度为59.SLDPRT
垂直尾翼 (2)/垂直尾翼/fin_第二翼肋_高度为59.SLDPRT
垂直尾翼 (2)/垂直尾翼/raw_垂直尾翼_高度为59.SLDPRT
垂直尾翼 (2)/垂直尾翼/raw_垂直尾翼_高度为59_3D打印版.SLDPRT
垂直尾翼 (2)/垂直尾翼/raw_垂直尾翼_高度为59_3D打印版.STEP
我真的是没招了/第一个tile_翼肋编号1-7.SLDDRW
我真的是没招了/第三个tile_第二横梁拆分及对应的两个卡扣_襟翼前挡板_水平尾翼翼肋1-5.SLDDRW
我真的是没招了/第二个tile_翼肋编号8-10_小翼_副翼前挡板_水平尾翼翼肋6_升降舵前挡板_水平尾翼卡扣_垂直尾翼翼肋1-2_方向舵挡板_垂直尾翼卡扣_插座板_插座.SLDDRW
水平尾翼/水平尾翼/raw_水平尾翼.SLDPRT
水平尾翼/水平尾翼/第五块翼肋.SLDPRT
航模设计Vcs_4.0/航模设计Vcs_4.0/4_0_side panel - fuck so shit.SLDPRT
航模设计Vcs_4.0/航模设计Vcs_4.0/主机翼/A_main_主机翼装配 - 副本.SLDASM
航模设计Vcs_4.0/航模设计Vcs_4.0/主机翼/Mirror副翼.SLDPRT
航模设计Vcs_4.0/航模设计Vcs_4.0/主机翼/Mirror引导塑料薄膜附着.SLDPRT
航模设计Vcs_4.0/航模设计Vcs_4.0/主机翼/Mirror襟翼.SLDPRT
航模设计Vcs_4.0/航模设计Vcs_4.0/主机翼/Mirror襟翼前龙骨挡板.SLDPRT
航模设计Vcs_4.0/航模设计Vcs_4.0/主机翼/副翼.SLDPRT
航模设计Vcs_4.0/航模设计Vcs_4.0/主机翼/副翼前挡板.SLDPRT
航模设计Vcs_4.0/航模设计Vcs_4.0/主机翼/襟翼.SLDPRT
航模设计Vcs_4.0/航模设计Vcs_4.0/主机翼/襟翼前龙骨挡板.SLDPRT
航模设计Vcs_4.0/航模设计Vcs_4.0/主机翼碳棒固定件 (4).SLDPRT
航模设计Vcs_4.0/航模设计Vcs_4.0/水平尾翼/A_main_水平尾翼 - 副本.SLDASM
航模设计Vcs_4.0/航模设计Vcs_4.0/水平尾翼/Mirrortail_塑料薄膜附着位点.SLDPRT
航模设计Vcs_4.0/航模设计Vcs_4.0/水平尾翼/Mirrortail_第一块翼肋.SLDPRT
航模设计Vcs_4.0/航模设计Vcs_4.0/水平尾翼/Mirrortail_第三块翼肋.SLDPRT
航模设计Vcs_4.0/航模设计Vcs_4.0/水平尾翼/Mirrortail_第二块翼肋.SLDPRT
航模设计Vcs_4.0/航模设计Vcs_4.0/水平尾翼/Mirrortail_第五块翼肋.SLDPRT
航模设计Vcs_4.0/航模设计Vcs_4.0/水平尾翼/Mirrortail_第六块翼肋.SLDPRT
航模设计Vcs_4.0/航模设计Vcs_4.0/水平尾翼/Mirror升降舵.SLDPRT
航模设计Vcs_4.0/航模设计Vcs_4.0/水平尾翼/Mirror半径为2mm的碳纤维棒.SLDPRT
航模设计Vcs_4.0/航模设计Vcs_4.0/水平尾翼/tail_卡扣.SLDPRT
航模设计Vcs_4.0/航模设计Vcs_4.0/水平尾翼/tail_第二块翼肋.SLDPRT
航模设计Vcs_4.0/航模设计Vcs_4.0/水平尾翼/tail_第五块翼肋.SLDPRT
航模设计Vcs_4.0/航模设计Vcs_4.0/水平尾翼/tail_第六块翼肋.SLDPRT
航模设计Vcs_4.0/航模设计Vcs_4.0/水平尾翼/tail_第四块翼肋.SLDPRT
航模设计Vcs_4.0/航模设计Vcs_4.0/水平尾翼/升降舵前挡板.SLDPRT
航模设计Vcs_4.0/航模设计Vcs_4.0/水平尾翼/半径为2mm的碳纤维棒.SLDPRT
飞机元器件拆解/飞机元器件拆解/激光切割/主机翼/襟翼前龙骨挡板.DXF
